revk/ESP32-Generic/PCB/Generic0/README.md

# Generic0

These files are for use in [KiCad](https://www.kicad.org).

## Trademark

This is an open source project, but bear in mind you cannot sell boards bearing the Andrews & Arnold Ltd name, the A&A logo, the registered trademark AJK logo, or the GS1 allocated EANs assigned to Andrews & Arnold Ltd.

## Images

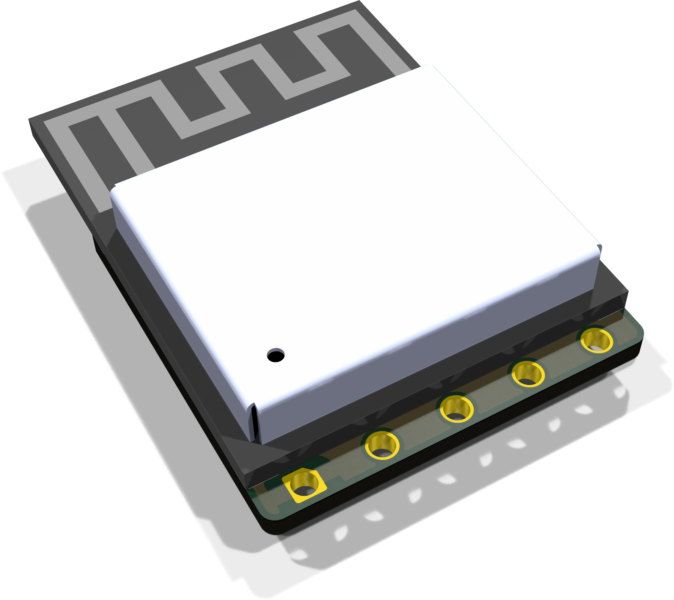
[picture p2: PCB/Generic0/Generic0.png]
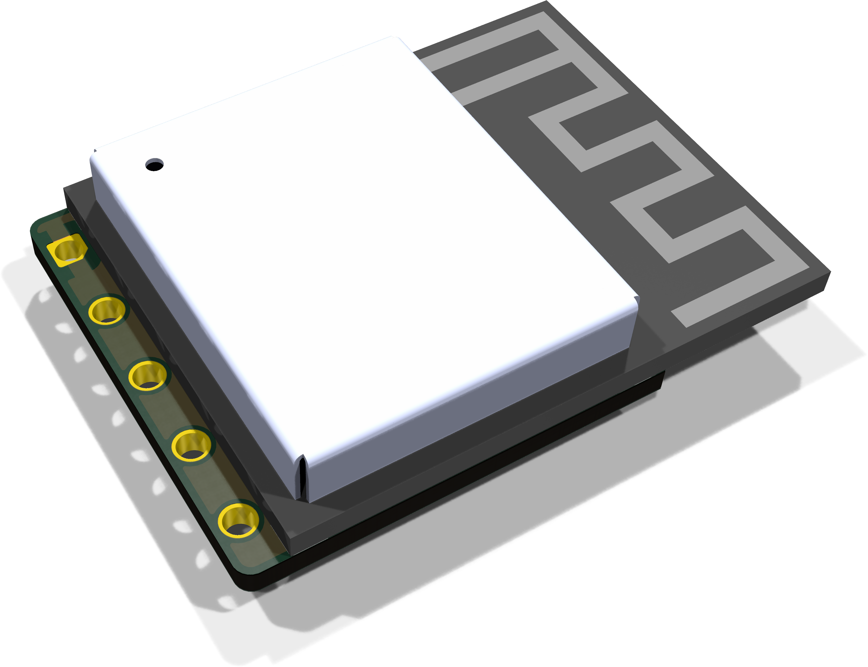
[picture p3: PCB/Generic0/Generic0-90.png]
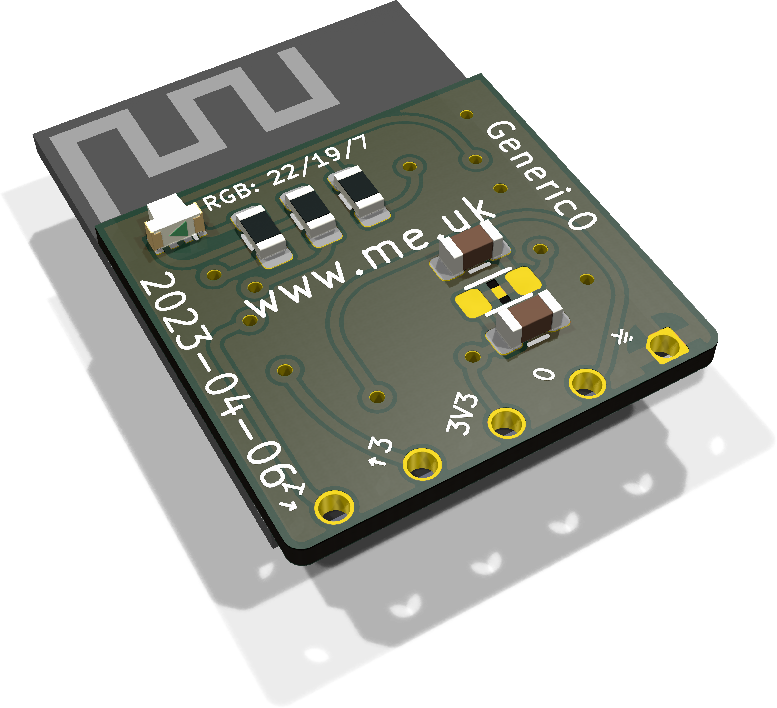
[picture p4: PCB/Generic0/Generic0-bottom.png]


*Auto generated 2025-08-24T13:27:21*
