revk/ESP32-Generic/PCB/Generic01/README.md

# Generic01

These files are for use in [KiCad](https://www.kicad.org).

## Trademark

This is an open source project, but bear in mind you cannot sell boards bearing the Andrews & Arnold Ltd name, the A&A logo, the registered trademark AJK logo, or the GS1 allocated EANs assigned to Andrews & Arnold Ltd.

## Images

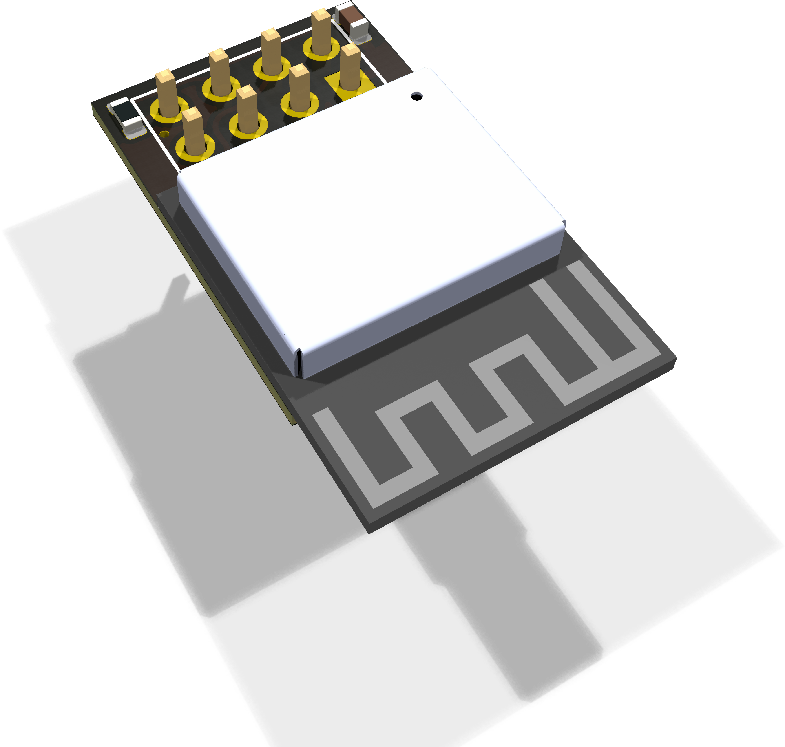
[picture p5: PCB/Generic01/Generic01.png]
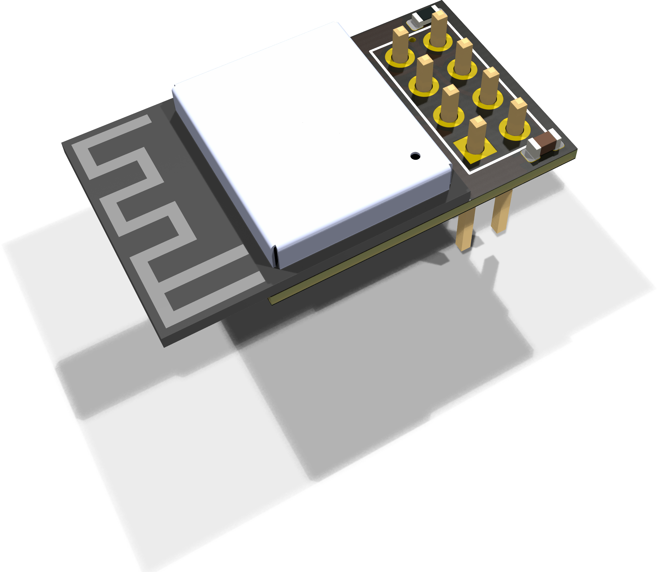
[picture p6: PCB/Generic01/Generic01-90.png]
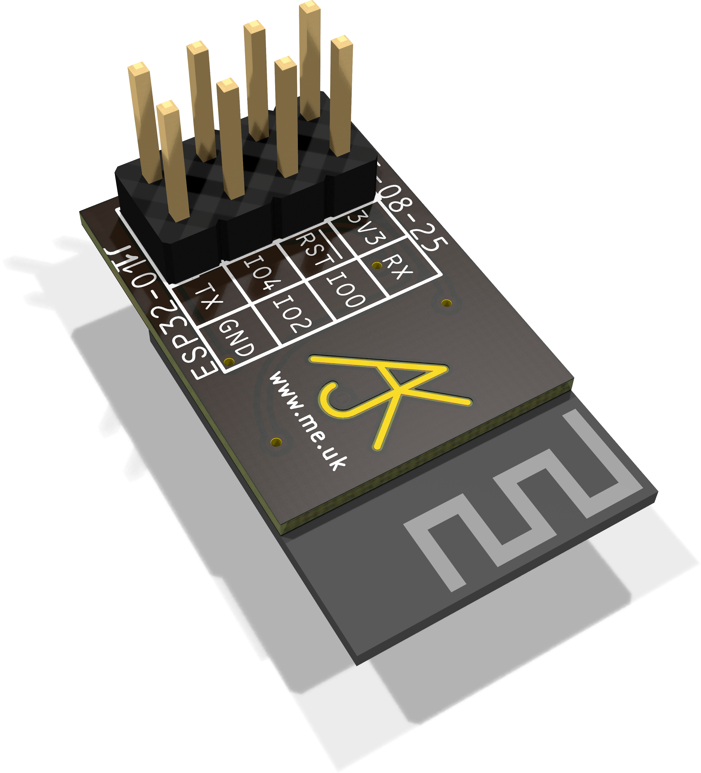
[picture p7: PCB/Generic01/Generic01-bottom.png]


*Auto generated 2025-08-24T13:28:44*
