revk/ESP32-Generic/PCB/Generic3/README.md

# Generic3

## Trademark

This is an open source project, but bear in mind you cannot sell boards bearing the Andrews & Arnold Ltd name, the A&A logo, the registered trademark AJK logo, or the GS1 allocated EANs assigned to Andrews & Arnold Ltd.

## PCB Designs

These files are for use with [KiCAD](https://www.kicad.org).

- [Generic3](Generic3.kicad_pro)
## 3D

3D case designs are normally automatically created from the PCB so as to ensure correct details and placement of apertures, etc.

- [Generic3](Generic3.stl)

## Images

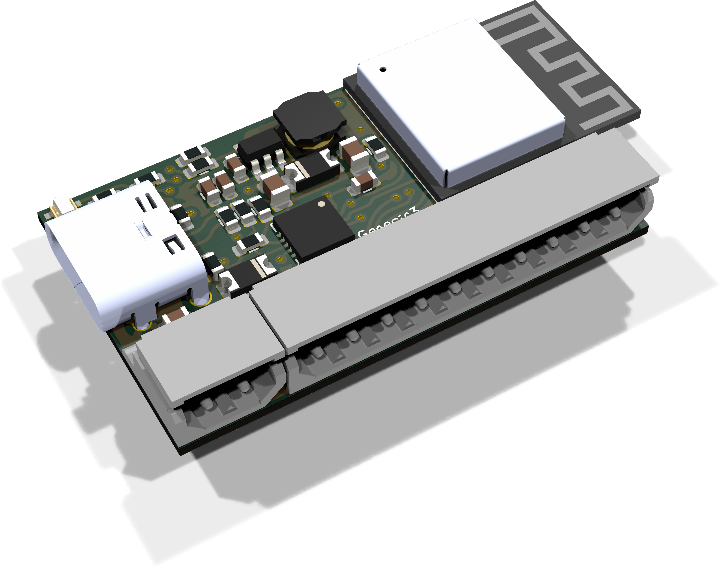
[picture p11: PCB/Generic3/Generic3.png]
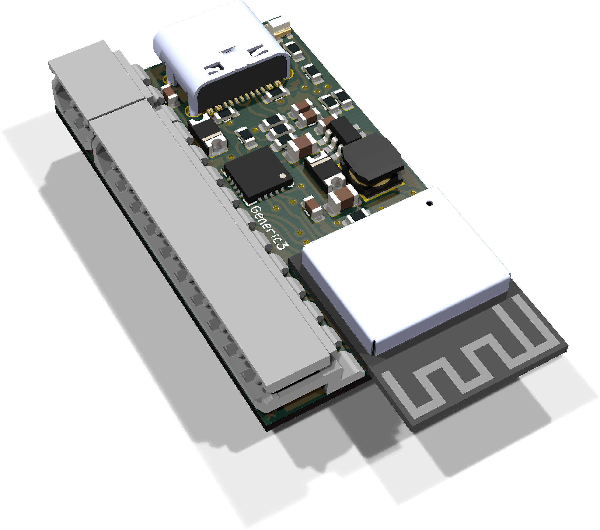
[picture p12: PCB/Generic3/Generic3-90.png]
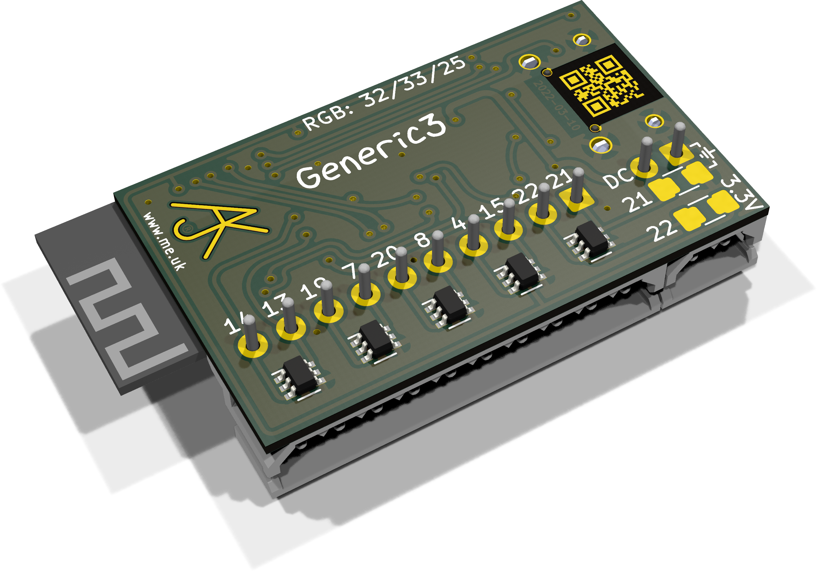
[picture p13: PCB/Generic3/Generic3-bottom.png]


---

*Auto generated README.md 2025-08-25T14:29:06*
