revk/ESP32-Generic/PCB/Generic4/README.md

# Generic4

## Trademark

This is an open source project, but bear in mind you cannot sell boards bearing the Andrews & Arnold Ltd name, the A&A logo, the registered trademark AJK logo, or the GS1 allocated EANs assigned to Andrews & Arnold Ltd.

## PCB Designs

These files are for use with [KiCAD](https://www.kicad.org).

- [Generic4](Generic4.kicad_pro)
## 3D

3D case designs are normally automatically created from the PCB so as to ensure correct details and placement of apertures, etc.

- [Generic4](Generic4.stl)

## Images

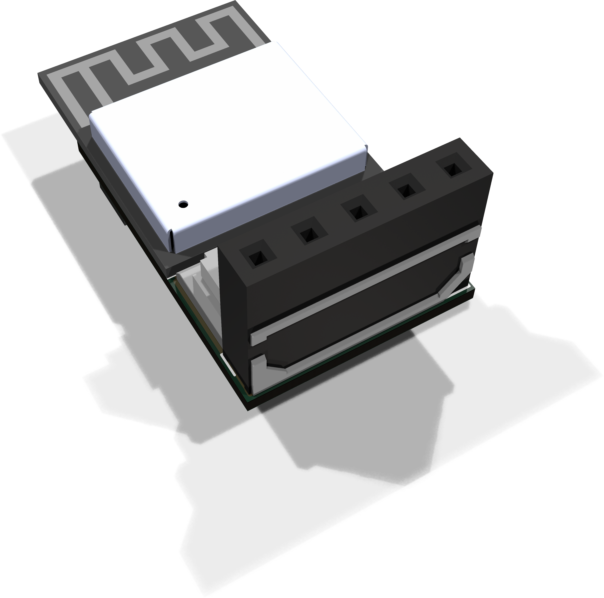
[picture p14: PCB/Generic4/Generic4.png]
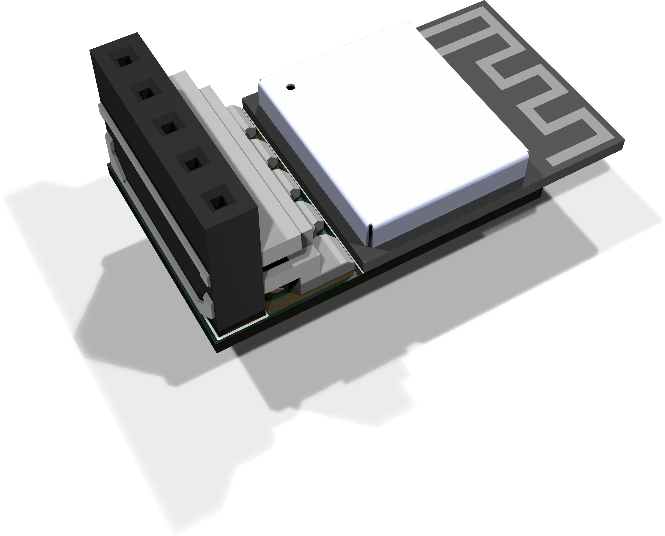
[picture p15: PCB/Generic4/Generic4-90.png]
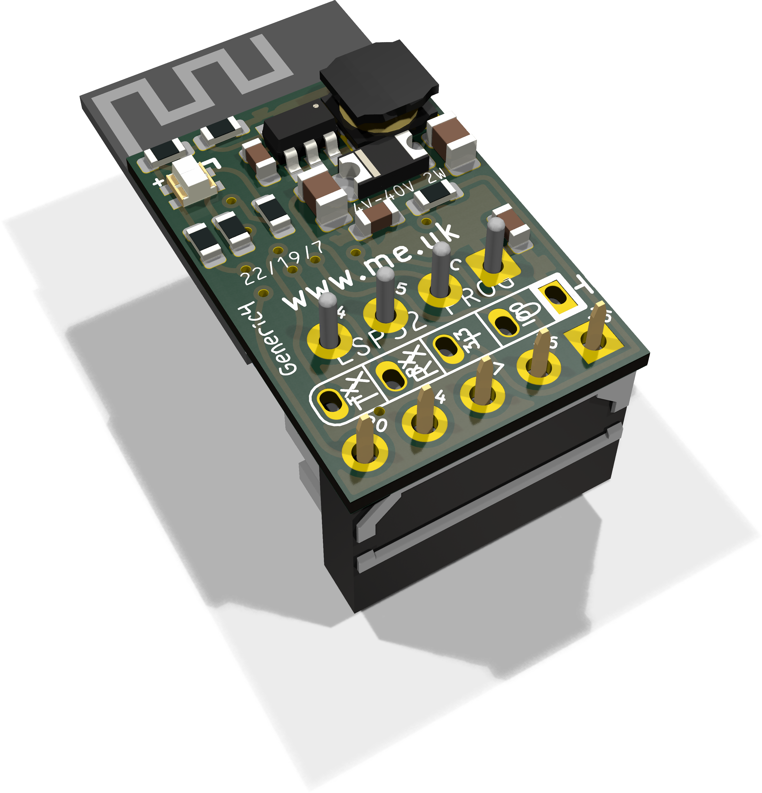
[picture p16: PCB/Generic4/Generic4-bottom.png]


---

*Auto generated README.md 2025-08-25T14:29:06*
