revk/ESP32-Generic/PCB/Generic6/README.md

# Generic6

These files are for use in [KiCad](https://www.kicad.org).

## Trademark

This is an open source project, but bear in mind you cannot sell boards bearing the Andrews & Arnold Ltd name, the A&A logo, the registered trademark AJK logo, or the GS1 allocated EANs assigned to Andrews & Arnold Ltd.

## Images

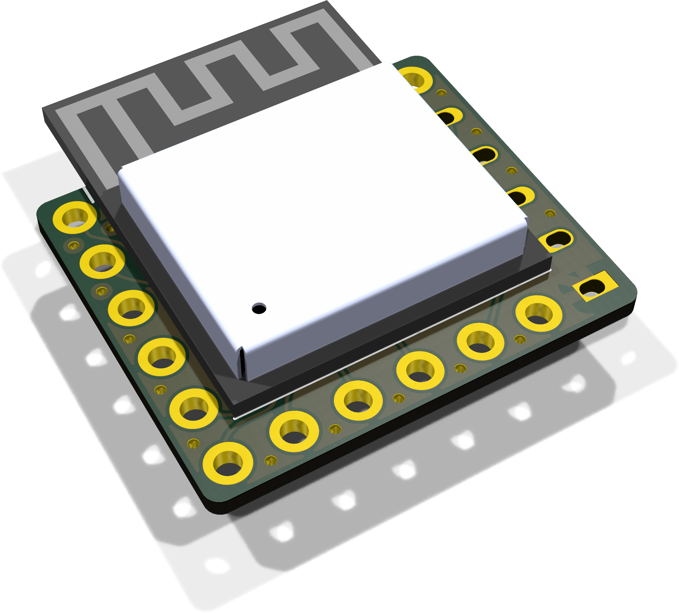
[picture p17: PCB/Generic6/Generic6.png]
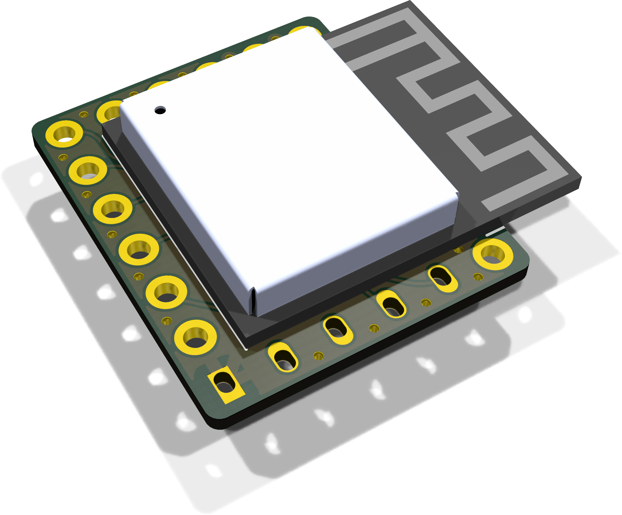
[picture p18: PCB/Generic6/Generic6-90.png]
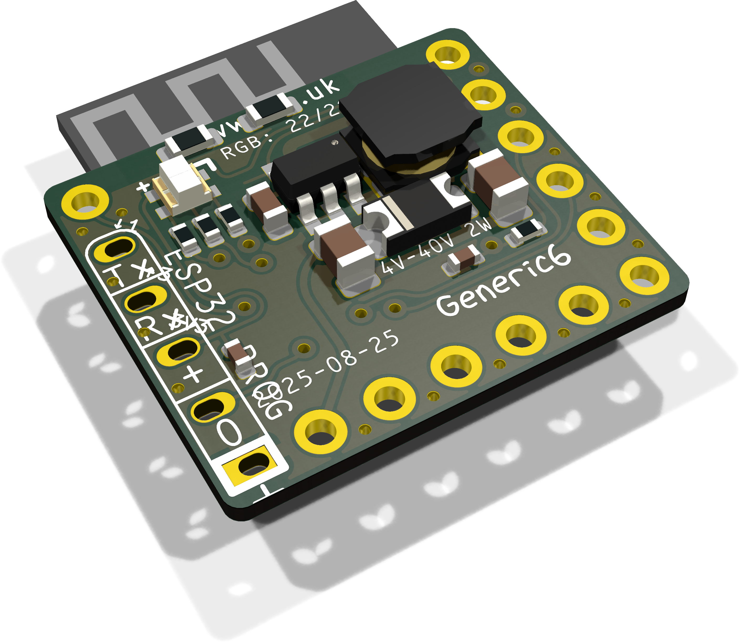
[picture p19: PCB/Generic6/Generic6-bottom.png]


*Auto generated 2025-08-24T13:35:26*
