revk/ESP32-Generic/PCB/GenericS3/README.md

# GenericS3

## Trademark

This is an open source project, but bear in mind you cannot sell boards bearing the Andrews & Arnold Ltd name, the A&A logo, the registered trademark AJK logo, or the GS1 allocated EANs assigned to Andrews & Arnold Ltd.

## PCB Designs

These files are for use with [KiCAD](https://www.kicad.org).

- [GenericS3](GenericS3.kicad_pro)
## 3D

3D case designs are normally automatically created from the PCB so as to ensure correct details and placement of apertures, etc.

|Design|Bottom|Top|
|---|---|---|
|GenericS3|[GenericS3B](GenericS3B.stl)|[GenericS3T](GenericS3T.stl)|

## Images

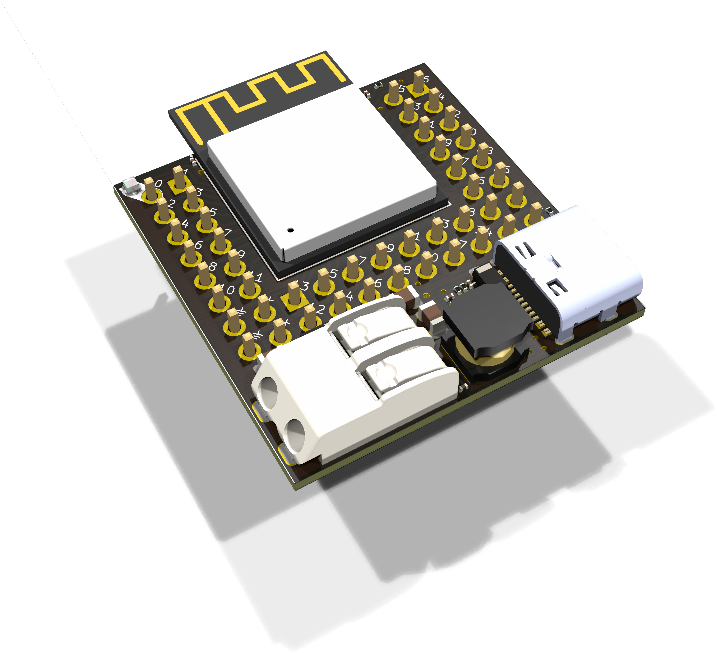
[picture p20: PCB/GenericS3/GenericS3-90.png]
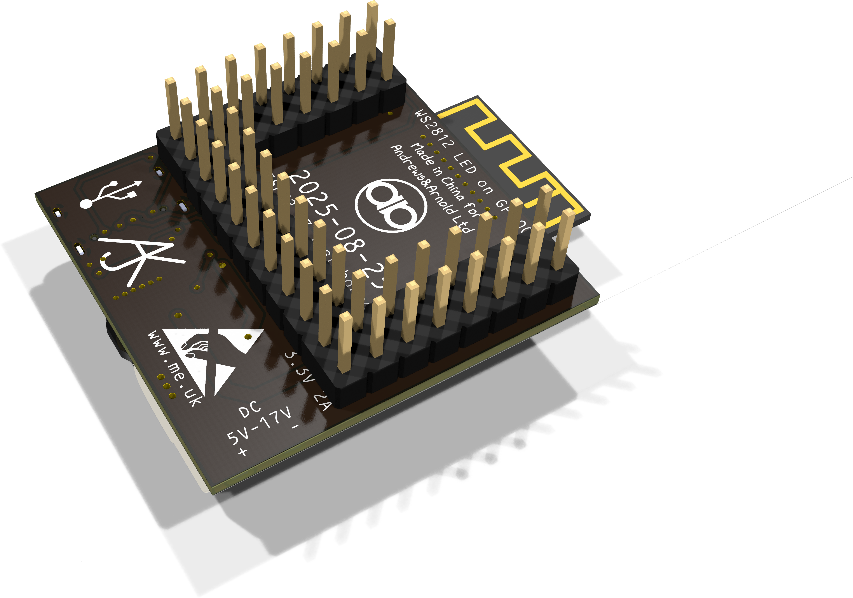
[picture p21: PCB/GenericS3/GenericS3-bottom.png]

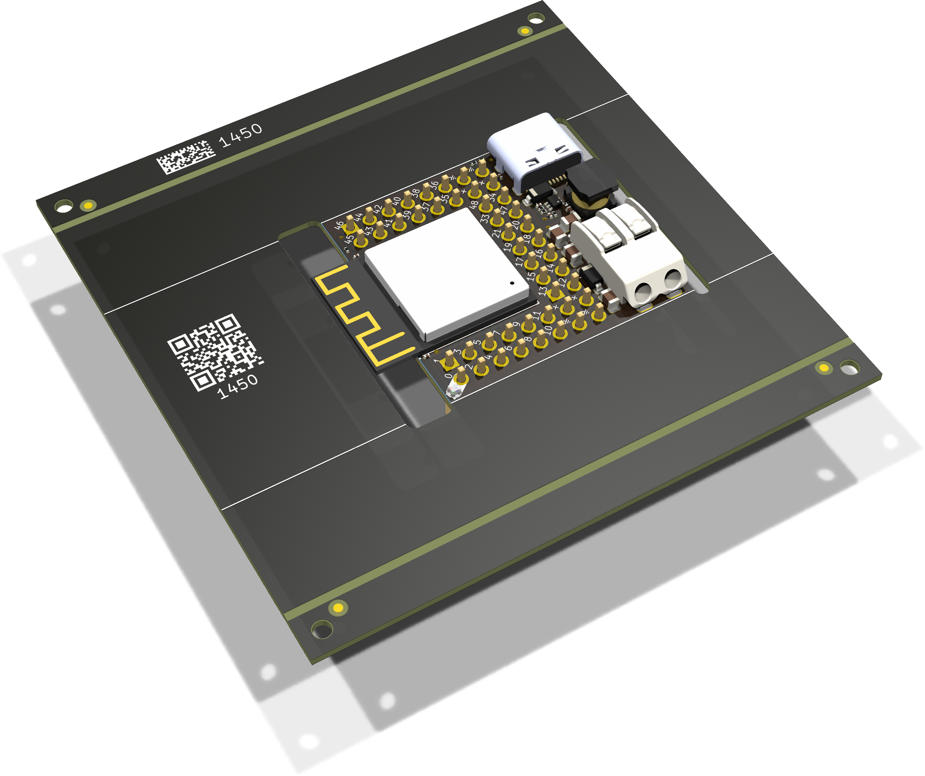
[picture p22: PCB/GenericS3/GenericS3-panel.png]
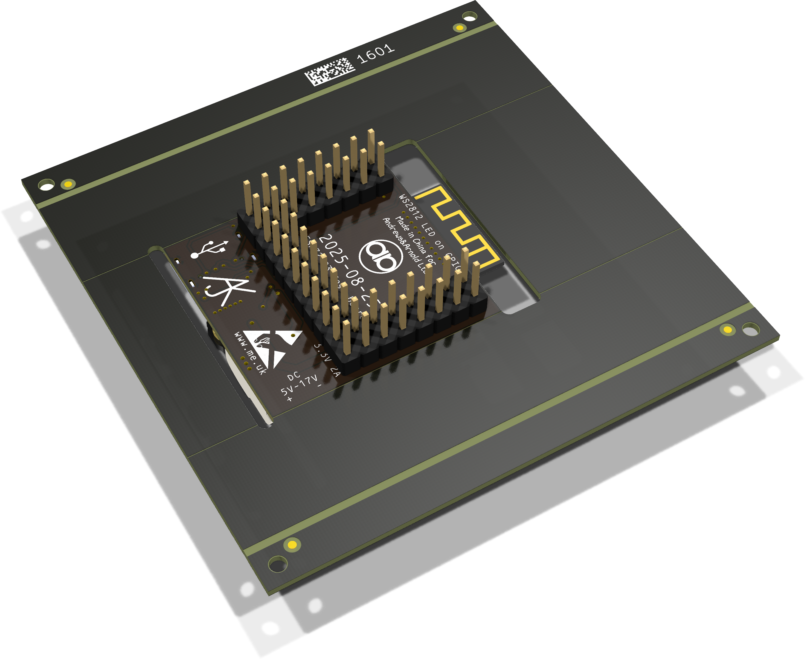
[picture p23: PCB/GenericS3/GenericS3-panel-bottom.png]


---

*Auto generated README.md 2025-08-25T15:22:12*
