revk/ESP32-Generic/PCB/GenericS3Bat/README.md

# GenericS3

These files are for use in [KiCad](https://www.kicad.org).

## Trademark

This is an open source project, but bear in mind you cannot sell boards bearing the Andrews & Arnold Ltd name, the A&A logo, the registered trademark AJK logo, or the GS1 allocated EANs assigned to Andrews & Arnold Ltd.

## Images

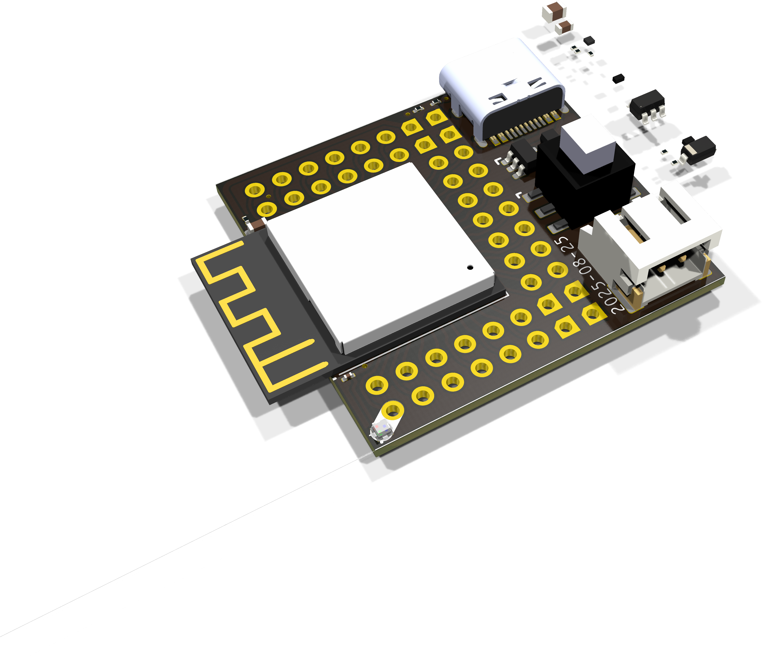
[picture p24: PCB/GenericS3Bat/GenericS3.png]
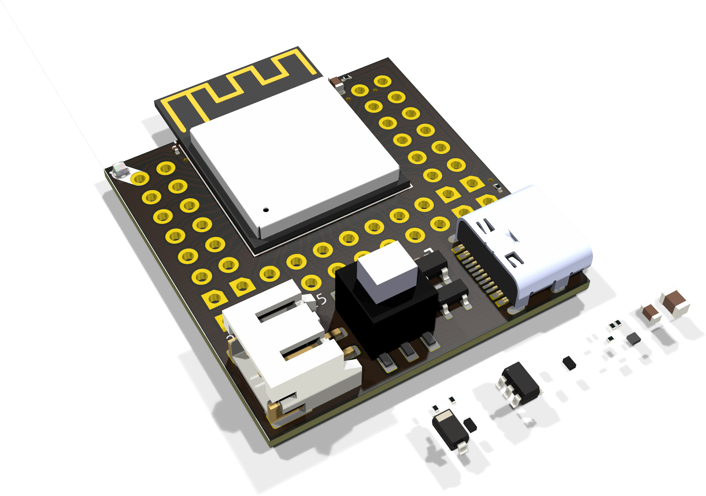
[picture p25: PCB/GenericS3Bat/GenericS3-90.png]
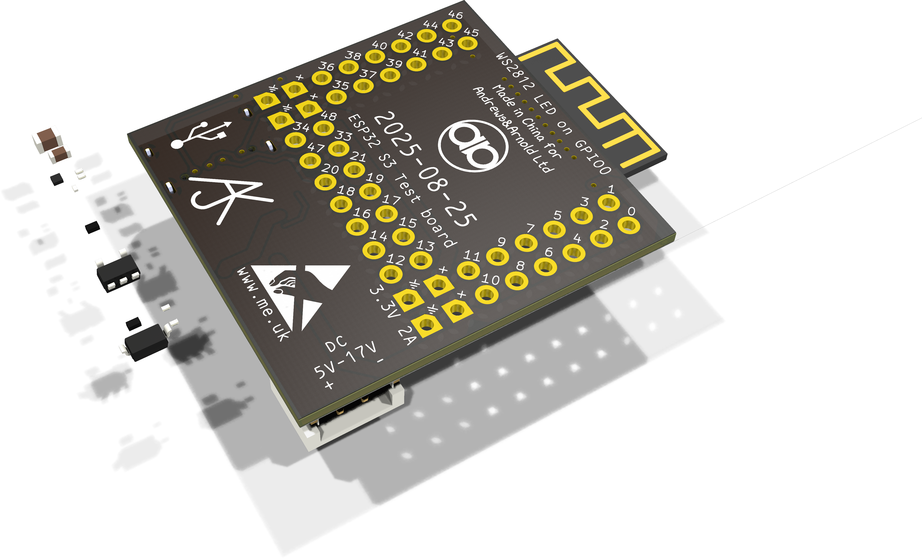
[picture p26: PCB/GenericS3Bat/GenericS3-bottom.png]

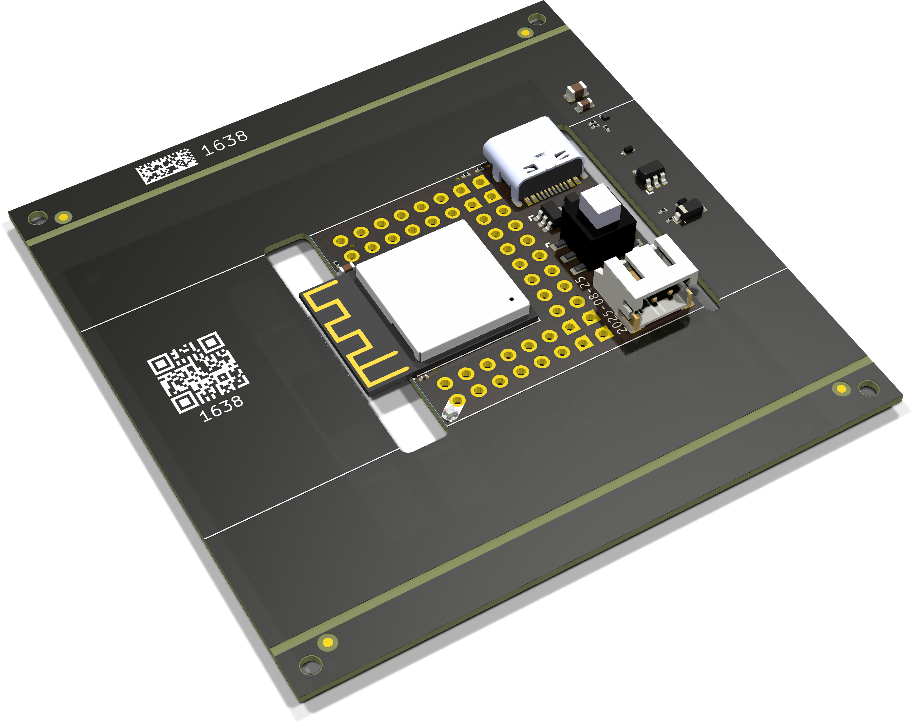
[picture p27: PCB/GenericS3Bat/GenericS3-panel.png]
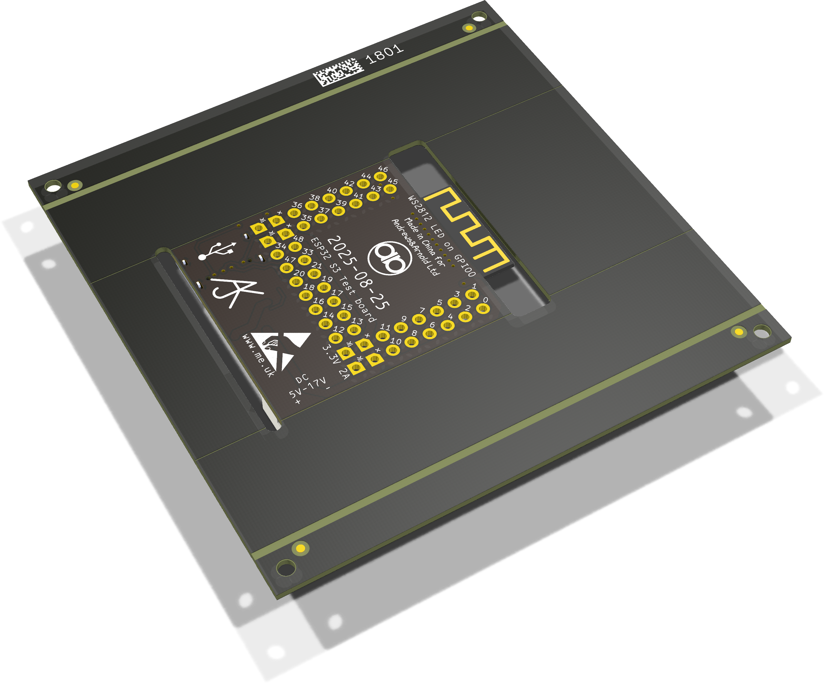
[picture p28: PCB/GenericS3Bat/GenericS3-panel-bottom.png]


*Auto generated 2025-08-24T13:42:13*
