revk/ESP32-Generic/PCB/LowPower/README.md

# LowPower

## Trademark

This is an open source project, but bear in mind you cannot sell boards bearing the Andrews & Arnold Ltd name, the A&A logo, the registered trademark AJK logo, or the GS1 allocated EANs assigned to Andrews & Arnold Ltd.

## PCB Designs

These files are for use with [KiCAD](https://www.kicad.org).

- [LowPower](LowPower.kicad_pro)
## 3D

3D case designs are normally automatically created from the PCB so as to ensure correct details and placement of apertures, etc.

- [LowPower](LowPower.stl)

## Images

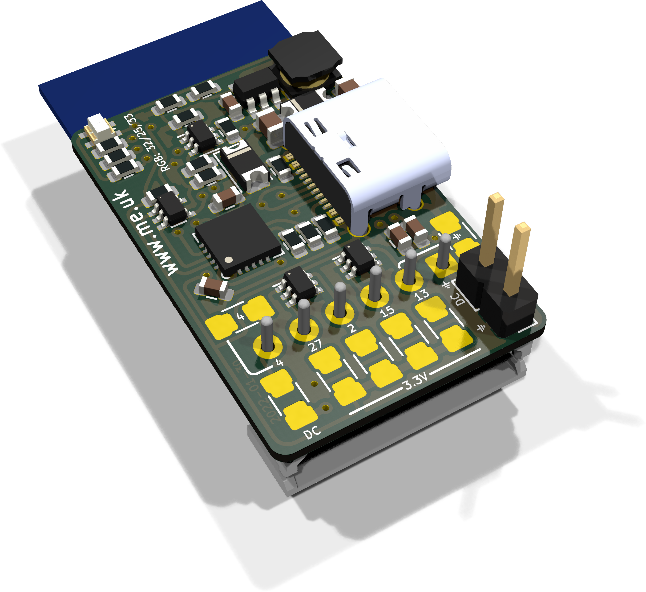
[picture p29: PCB/LowPower/LowPower.png]
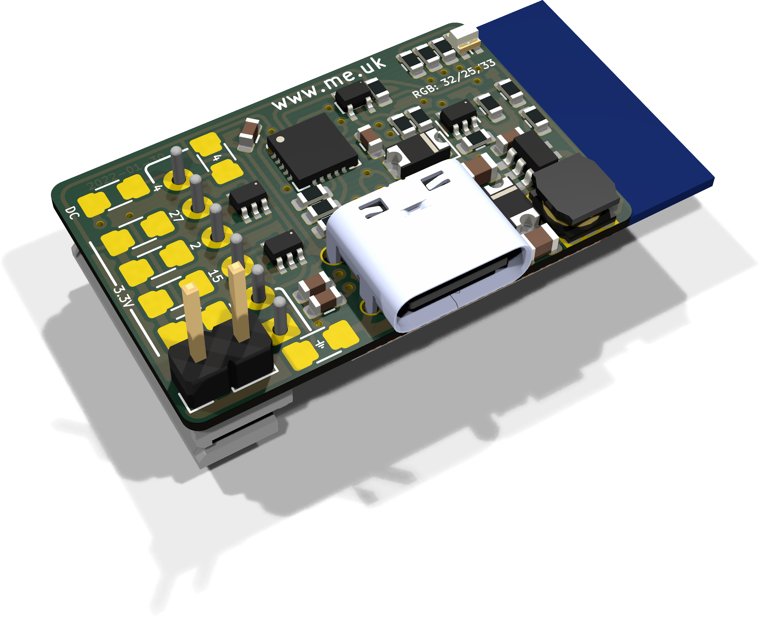
[picture p30: PCB/LowPower/LowPower-90.png]
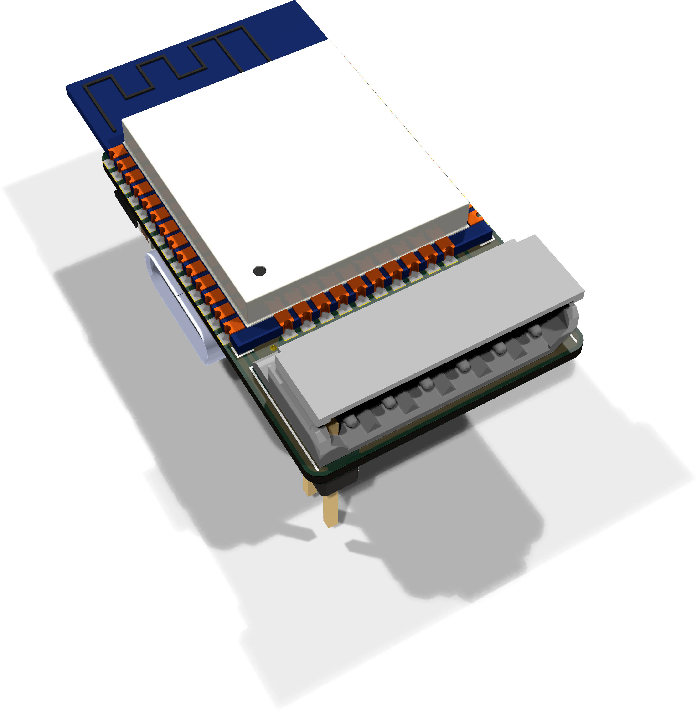
[picture p31: PCB/LowPower/LowPower-bottom.png]


---

*Auto generated README.md 2025-08-25T14:29:06*
