revk/ESP32-Generic/PCB/USBC/README.md

# USBC

These files are for use in [KiCad](https://www.kicad.org).

## Trademark

This is an open source project, but bear in mind you cannot sell boards bearing the Andrews & Arnold Ltd name, the A&A logo, the registered trademark AJK logo, or the GS1 allocated EANs assigned to Andrews & Arnold Ltd.

## Images

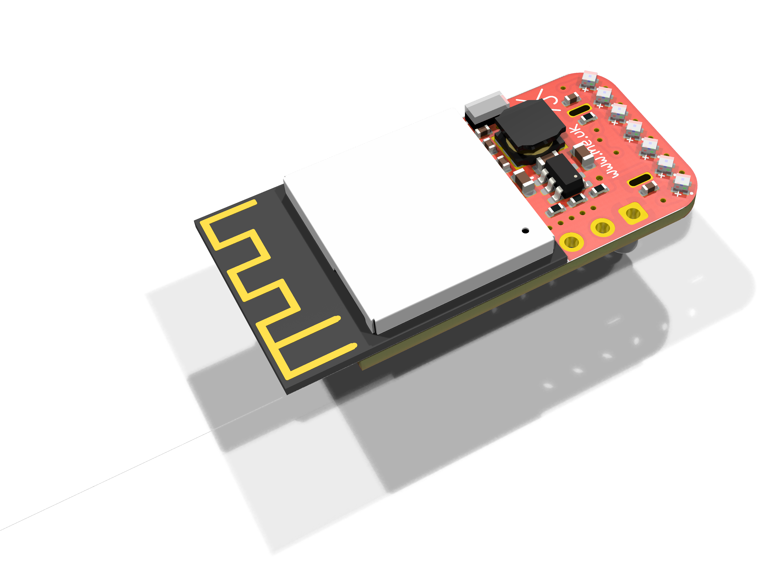
[picture p32: PCB/USBC/USBC.png]
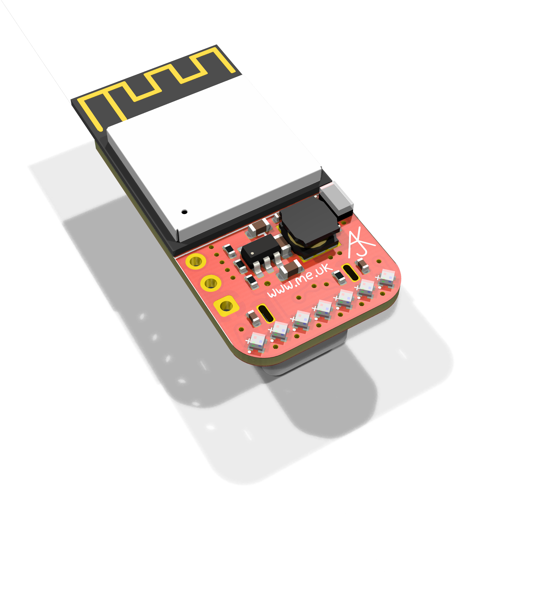
[picture p33: PCB/USBC/USBC-90.png]
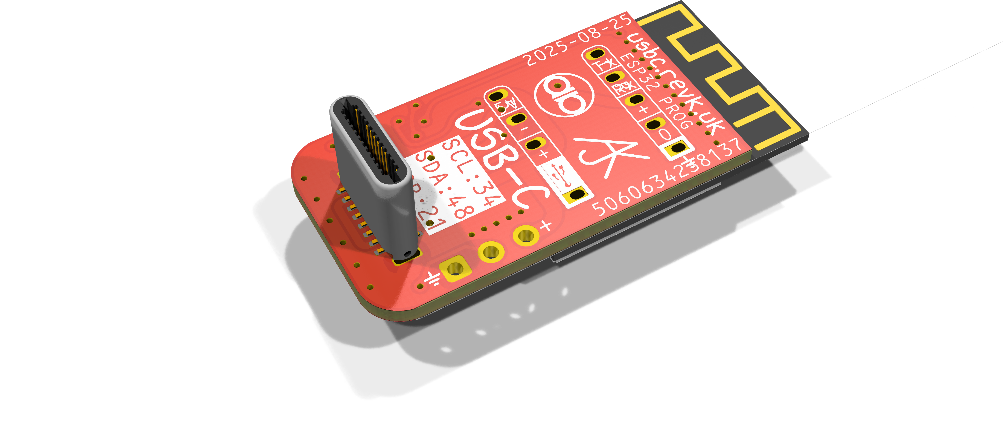
[picture p34: PCB/USBC/USBC-bottom.png]

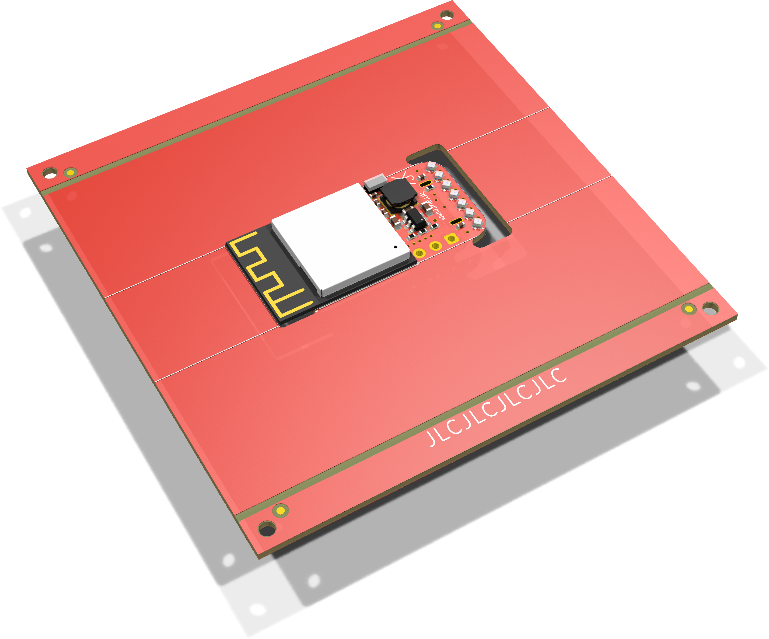
[picture p35: PCB/USBC/USBC-panel.png]
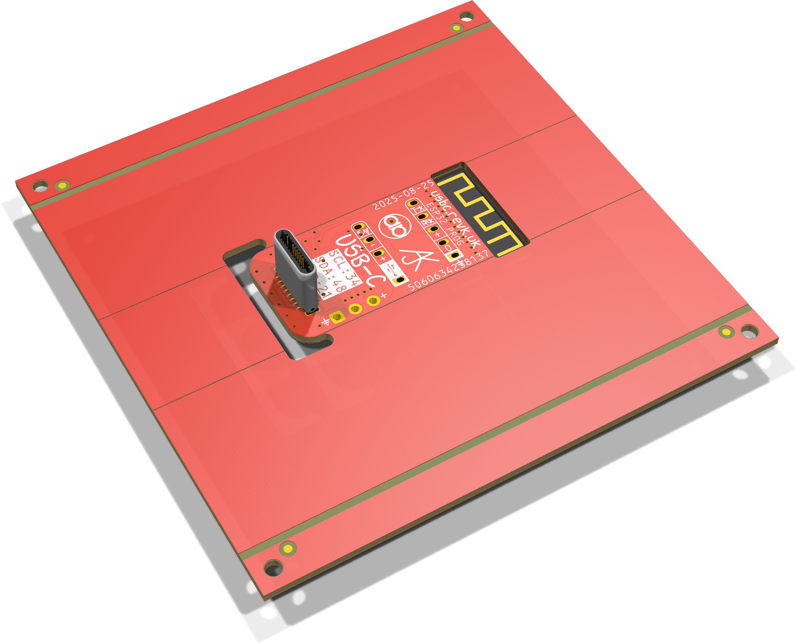
[picture p36: PCB/USBC/USBC-panel-bottom.png]


*Auto generated 2025-08-24T13:46:48*
