revk/ESP32-Generic/PCB/Generic0/Back.png

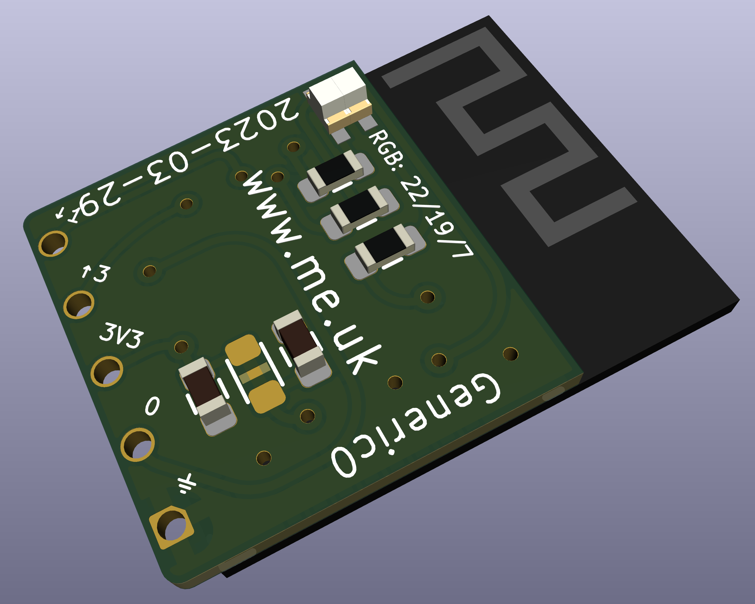
PCB/Generic0/Back.png
