revk/ESP32-Generic/PCB/Generic0/Front.png

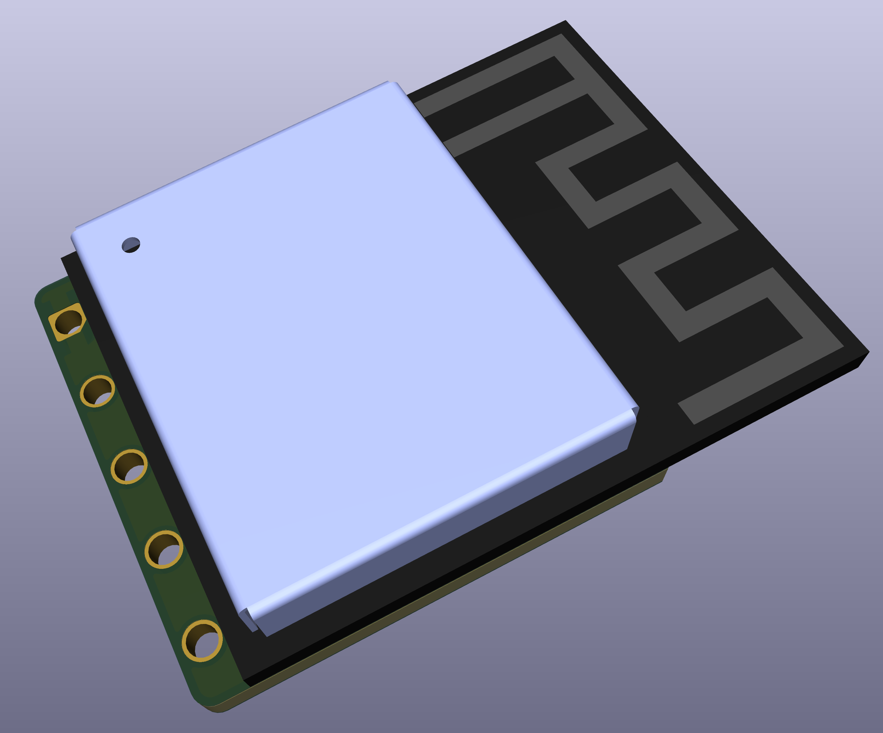
PCB/Generic0/Front.png
