revk/ESP32-Generic/PCB/Generic/Generic-90.png

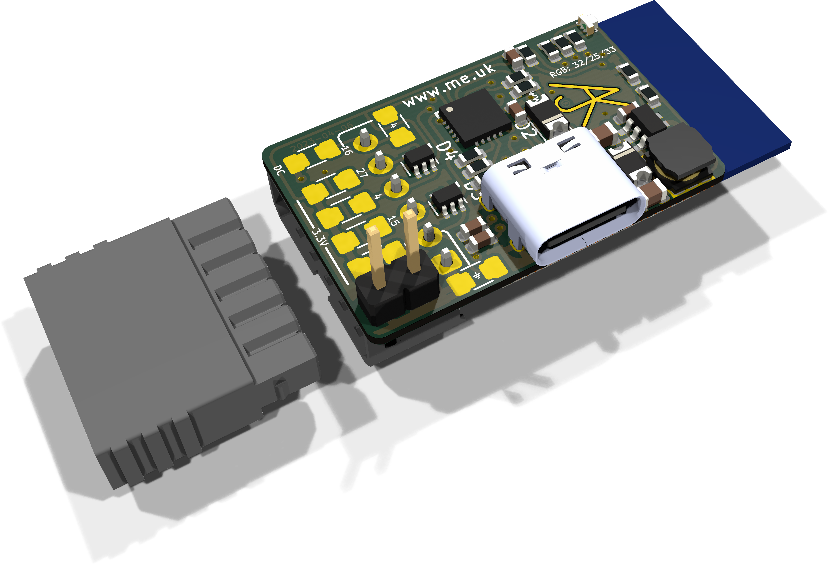
PCB/Generic/Generic-90.png
