revk/ESP32-Generic/PCB/Generic/Generic-bottom.png

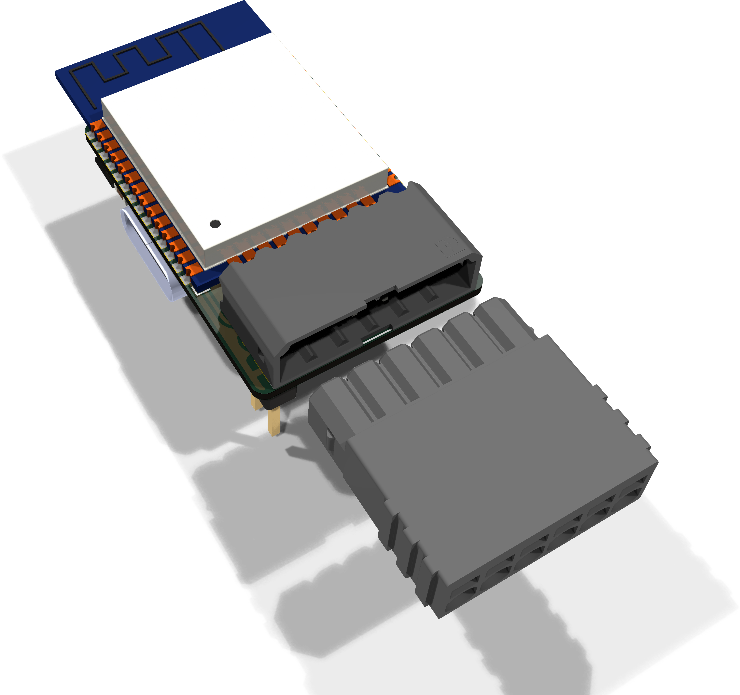
PCB/Generic/Generic-bottom.png
