revk/ESP32-Generic/PCB/Generic/Generic.png

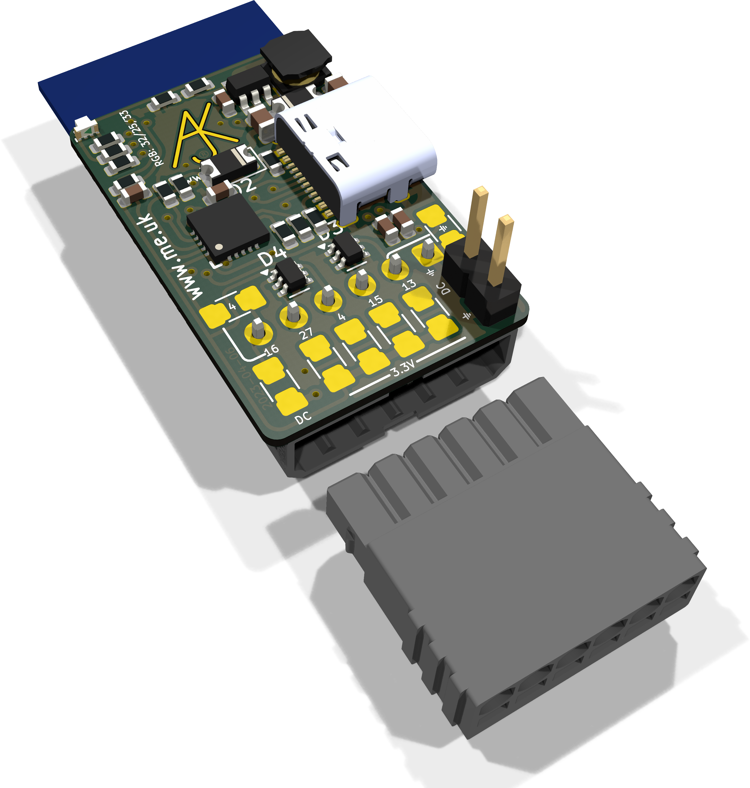
PCB/Generic/Generic.png
