revk/ESP32-Generic/PCB/GenericS3/Back.png

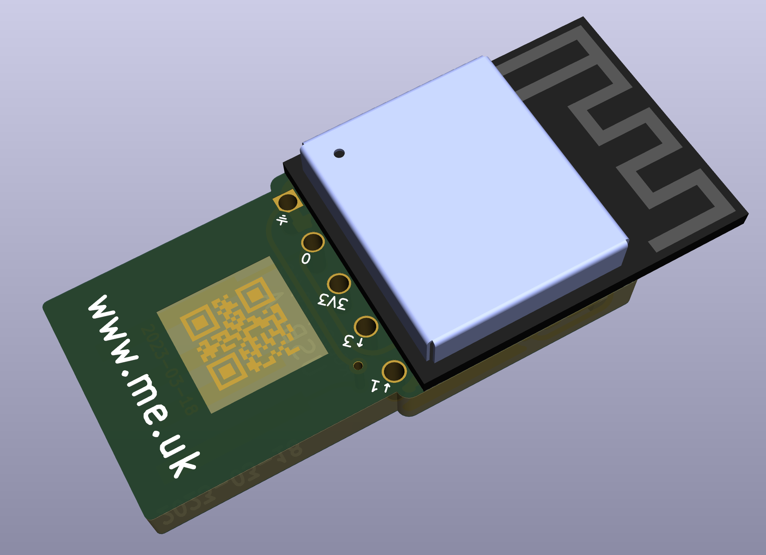
PCB/GenericS3/Back.png
