revk/ESP32-Generic/PCB/GenericS3/Example.png

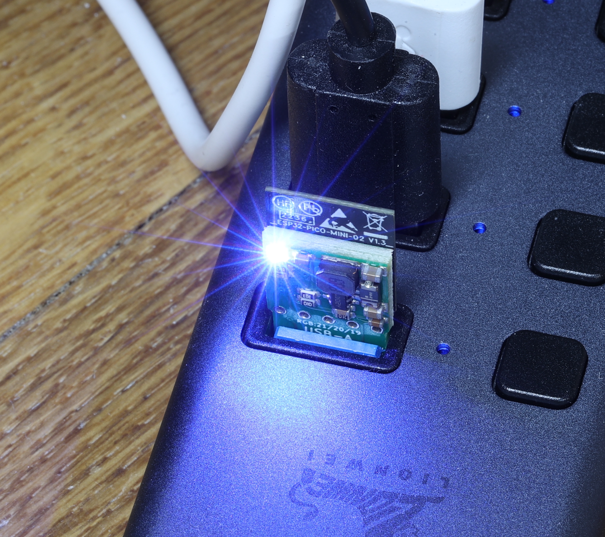
PCB/GenericS3/Example.png
