revk/ESP32-Generic/PCB/GenericS3/Front.png

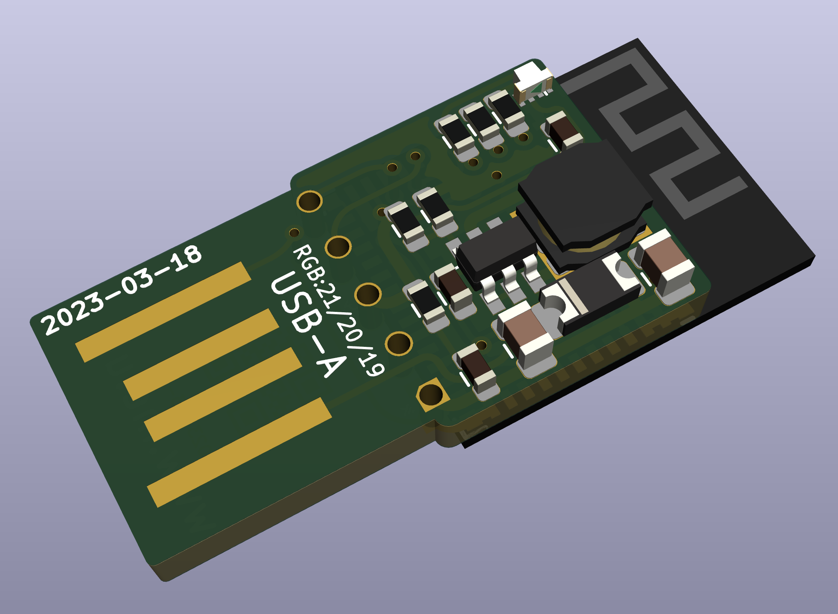
PCB/GenericS3/Front.png
