revk/ESP32-Generic/PCB/Generic0/production/bom.csv

Designator | Footprint | Quantity | Value | LCSC Part #
C1 | C_0603 | 1 | 10nF
C2 | C_0603 | 1 | 100nF
D1 | MHS190RGBCT | 1 | LED_BARG | C409798
J1 | Shelly | 1 | Shelly
R1 | R_0603 | 1 | 300R
R2 | R_0603 | 1 | 1K
R3 | R_0603 | 1 | 100R
R4 | Pad_0603_Bridged | 1 | 10K
U1 | ESP32-PICO-MINI-02 | 1 | ESP32-PICO-MINI-02
