revk/ESP32-Generic/PCB/Generic/Generic.stl

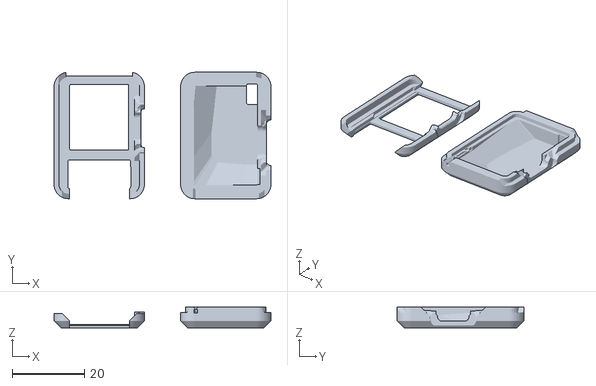
[picture p45: CAD file, 2023-04-07]
PCB/Generic/Generic.stl
60.0 x 35.0 x 5.80
