revk/ESP32-Generic/PCB/Generic2/Generic2.stl

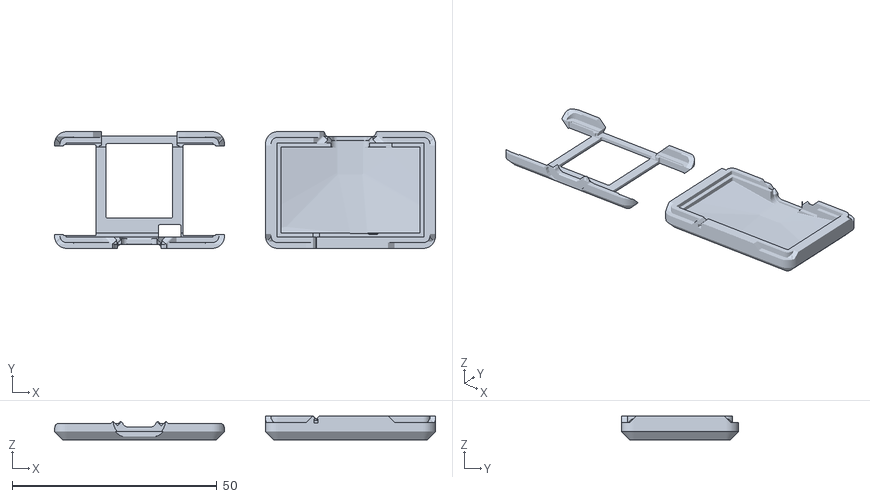
[picture p46: CAD file, 2023-04-07]
PCB/Generic2/Generic2.stl
93.0 x 28.5 x 5.80
