revk/ESP32-Generic/PCB/Generic3/Generic3.stl

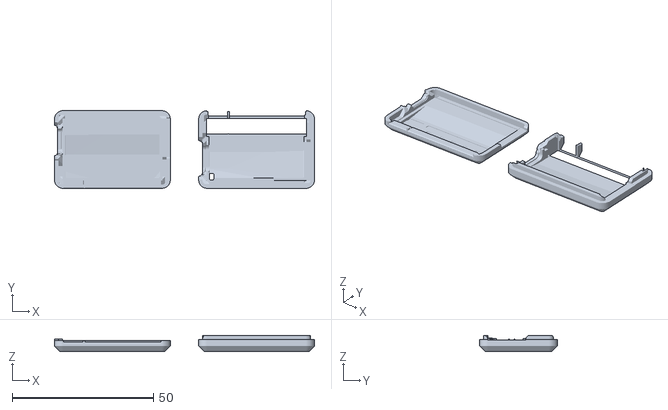
[picture p47: CAD file, 2023-04-07]
PCB/Generic3/Generic3.stl
92.0 x 27.5 x 5.80
