revk/ESP32-Generic/PCB/Generic4/Generic4.stl

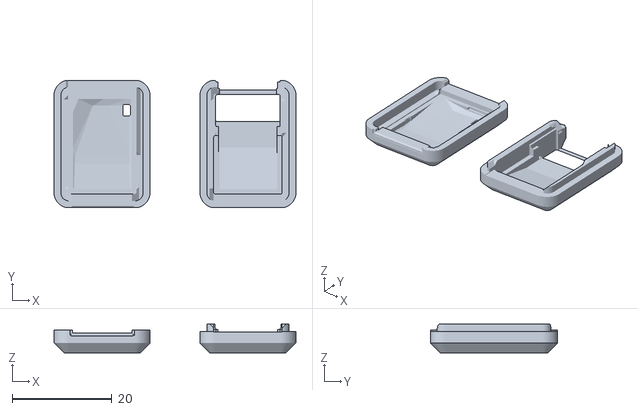
[picture p48: CAD file, 2023-04-07]
PCB/Generic4/Generic4.stl
48.4 x 25.5 x 5.80
