revk/ESP32-Generic/PCB/GenericS3/GenericS3T.stl

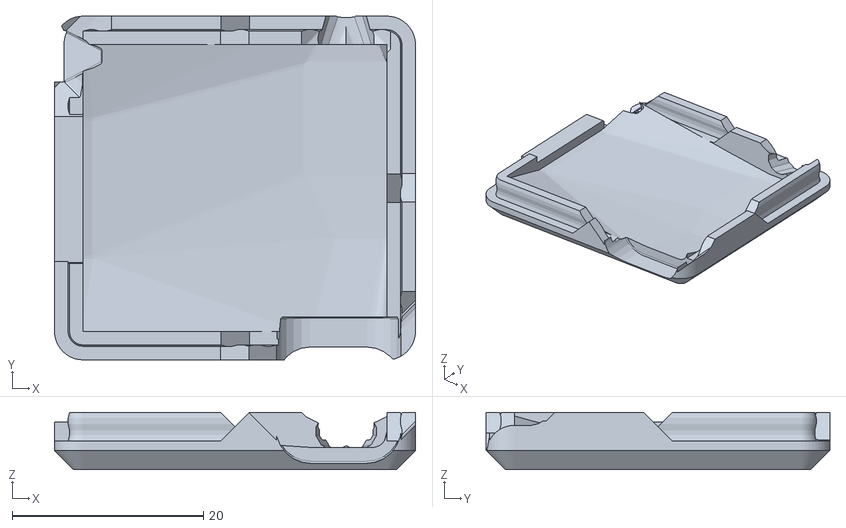
[picture p49: CAD file, 2025-11-13]
PCB/GenericS3/GenericS3T.stl
37.8 x 36.0 x 5.99
