revk/ESP32-Generic/PCB/LowPower/LowPower.stl

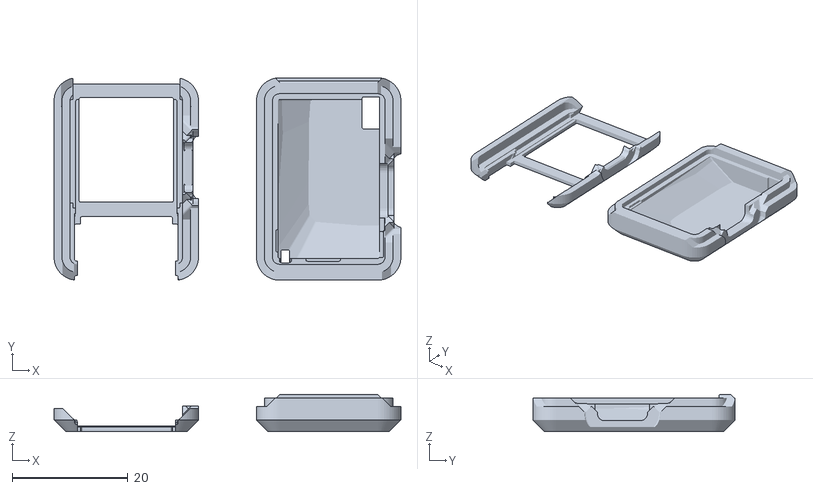
[picture p50: CAD file, 2023-04-07]
PCB/LowPower/LowPower.stl
60.0 x 35.0 x 6.40
