revk/ESP32-Generic/PCB/GenericS3/GenericS3B.stl

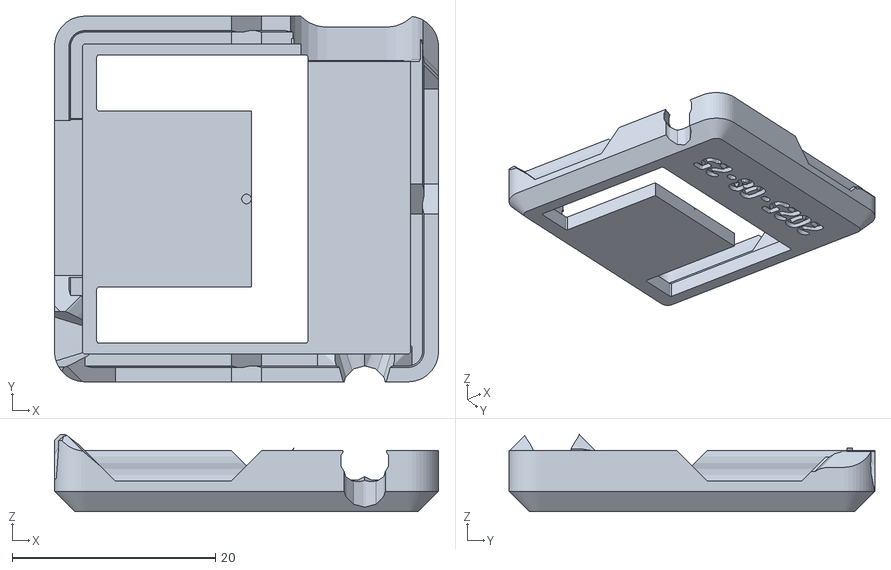
[picture p51: CAD file, 2025-11-13]
PCB/GenericS3/GenericS3B.stl
37.8 x 36.0 x 7.59
