revk/ESP32-Generic/(list of files, cad)

Other CAD files:
PCB/Generic2/Generic2.scad
PCB/Generic3/Generic3.scad
PCB/Generic4/Generic4.scad
PCB/GenericS3/GenericS3T.scad
PCB/LowPower/LowPower.scad
