revk/ESP32-Generic/(commit log)

2021-05-20 Battery PCB
    [Battery-B_Cu.gbr, Battery-B_Mask.gbr, Battery-B_Paste.gbr, Battery-B_SilkS.gbr, Battery-Edge_Cuts.gbr, Battery-F_Cu.gbr, Battery-F_Mask.gbr, Battery-F_Paste.gbr]
2021-05-20 Fucked up footprint.
    [Battery-B_Cu.gbr, Battery-B_Mask.gbr, Battery-B_Paste.gbr, Battery-B_SilkS.gbr, Battery-Edge_Cuts.gbr, Battery-F_Cu.gbr, Battery-F_Mask.gbr, Battery-F_Paste.gbr]
2021-05-22 Tidy up PCB
    [Battery-B_Cu.gbr, Battery-B_Mask.gbr, Battery-B_Paste.gbr, Battery-B_SilkS.gbr, Battery-Edge_Cuts.gbr, Battery-F_Cu.gbr, Battery-F_Mask.gbr, Battery-F_Paste.gbr]
2021-05-22 Still too much current
2021-05-22 Library update
    [Battery-B_Cu.gbr, Battery-B_Mask.gbr, Battery-B_Paste.gbr, Battery-B_SilkS.gbr, Battery-Edge_Cuts.gbr, Battery-F_Cu.gbr, Battery-F_Mask.gbr, Battery-F_Paste.gbr]
2021-05-22 Tidy, low current now
    [Battery-B_Cu.gbr, Battery-B_Mask.gbr, Battery-B_Paste.gbr, Battery-B_SilkS.gbr, Battery-Edge_Cuts.gbr, Battery-F_Cu.gbr, Battery-F_Mask.gbr, Battery-F_Paste.gbr]
2021-05-22 Still broken!
    [Battery.sch]
2021-05-22 Fixed circuit
    [Battery-B_Cu.gbr, Battery-B_Mask.gbr, Battery-B_Paste.gbr, Battery-B_SilkS.gbr, Battery-Edge_Cuts.gbr, Battery-F_Cu.gbr, Battery-F_Mask.gbr, Battery-F_Paste.gbr]
2021-05-22 Pin out
    [Battery.sch]
2021-05-23 New regulator
    [Battery-B_Cu.gbr, Battery-B_Mask.gbr, Battery-B_Paste.gbr, Battery-B_SilkS.gbr, Battery-Edge_Cuts.gbr, Battery-F_Cu.gbr, Battery-F_Mask.gbr, Battery-F_Paste.gbr]
2021-05-23 Tweak regulater
    [Battery-B_Cu.gbr, Battery-B_Mask.gbr, Battery-B_Paste.gbr, Battery-B_SilkS.gbr, Battery-Edge_Cuts.gbr, Battery-F_Cu.gbr, Battery-F_Mask.gbr, Battery-F_Paste.gbr]
2021-05-24 Added BCD_Charger
    [Battery-B_Cu.gbr, Battery-B_Mask.gbr, Battery-B_Paste.gbr, Battery-B_SilkS.gbr, Battery-Edge_Cuts.gbr, Battery-F_Cu.gbr, Battery-F_Mask.gbr, Battery-F_Paste.gbr]
2021-05-24 USB present is powered CBUS pin
    [Battery.kicad_pcb, Battery.sch]
2021-05-24 Lower power
2021-05-27 Update documentation
    [Battery-B_Cu.gbr, Battery-B_Mask.gbr, Battery-B_Paste.gbr, Battery-B_SilkS.gbr, Battery-Edge_Cuts.gbr, Battery-F_Cu.gbr, Battery-F_Mask.gbr, Battery-F_Paste.gbr]
2021-05-27 Wrong footprint FFS
    [Battery-B_Cu.gbr, Battery-B_Mask.gbr, Battery-B_Paste.gbr, Battery-B_SilkS.gbr, Battery-Edge_Cuts.gbr, Battery-F_Cu.gbr, Battery-F_Mask.gbr, Battery-F_Paste.gbr]
2021-05-27 Fix close via
    [Battery-B_Cu.gbr, Battery-B_Mask.gbr, Battery-B_Paste.gbr, Battery-B_SilkS.gbr, Battery-Edge_Cuts.gbr, Battery-F_Cu.gbr, Battery-F_Mask.gbr, Battery-F_Paste.gbr]
2021-05-28 LED is -ve
2021-05-30 Power up start
2021-05-31 Tidy drawing
    [Battery.kicad_pcb, Battery.stl]
2021-06-17 Better footprint for solder paste
    [Battery-B_Cu.gbr, Battery-B_Mask.gbr, Battery-B_Paste.gbr, Battery-B_SilkS.gbr, Battery-Edge_Cuts.gbr, Battery-F_Cu.gbr, Battery-F_Mask.gbr, Battery-F_Paste.gbr]
2021-06-20 Reworked with RGB LED, and 27R for USB and protection diodes...
    [Battery-B_Cu.gbr, Battery-B_Mask.gbr, Battery-B_Paste.gbr, Battery-B_SilkS.gbr, Battery-Edge_Cuts.gbr, Battery-F_Cu.gbr, Battery-F_Mask.gbr, Battery-F_Paste.gbr]
2021-06-20 Extra caps on USB as per data sheet
    [Battery-B_Cu.gbr, Battery-B_Mask.gbr, Battery-B_Paste.gbr, Battery-B_SilkS.gbr, Battery-Edge_Cuts.gbr, Battery-F_Cu.gbr, Battery-F_Mask.gbr, Battery-F_Paste.gbr]
2021-06-20 Documentation update
    [Battery.kicad_pcb]
2021-06-20 Clean up ground fill a bit
    [Battery-B_Cu.gbr, Battery-B_Mask.gbr, Battery-B_Paste.gbr, Battery-B_SilkS.gbr, Battery-Edge_Cuts.gbr, Battery-F_Cu.gbr, Battery-F_Mask.gbr, Battery-F_Paste.gbr]
2021-07-06 New footprint
    [Battery.kicad_pcb]
2021-07-09 Less solder on USB
    [Battery-B_Cu.gbr, Battery-B_Mask.gbr, Battery-B_Paste.gbr, Battery-B_SilkS.gbr, Battery-Edge_Cuts.gbr, Battery-F_Cu.gbr, Battery-F_Mask.gbr, Battery-F_Paste.gbr]
2021-07-10 Fix LED
    [Battery-B_Cu.gbr, Battery-B_Mask.gbr, Battery-B_Paste.gbr, Battery-B_SilkS.gbr, Battery-Edge_Cuts.gbr, Battery-F_Cu.gbr, Battery-F_Mask.gbr, Battery-F_Paste.gbr]
2021-07-20 Changed name
    [Battery-nohole.stl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]
2021-07-28 Filling out data in schematic
    [Generic.kicad_pcb, Generic.sch]
2021-08-24 Clean up
    [Generic-B_Cu.gbr, Generic-B_Mask.gbr, Generic-B_Paste.gbr, Generic-B_SilkS.gbr, Generic-Edge_Cuts.gbr, Generic-F_Cu.gbr, Generic-F_Mask.gbr, Generic-F_Paste.gbr]
2021-08-26 New regulator block
    [Generic-B_Cu.gbr, Generic-B_Mask.gbr, Generic-B_Paste.gbr, Generic-B_SilkS.gbr, Generic-Edge_Cuts.gbr, Generic-F_Cu.gbr, Generic-F_Mask.gbr, Generic-F_Paste.gbr]
2021-10-07 make pull
    [Generic.kicad_pcb]
2021-11-06 USB-A simple device
    [USBA-B_Cu.gbr, USBA-B_Mask.gbr, USBA-B_Paste.gbr, USBA-B_SilkS.gbr, USBA-Edge_Cuts.gbr, USBA-F_Cu.gbr, USBA-F_Mask.gbr, USBA-F_Paste.gbr]
2021-11-06 New QR
    [USBA-B_Cu.gbr, USBA-B_Mask.gbr, USBA-B_Paste.gbr, USBA-B_SilkS.gbr, USBA-Edge_Cuts.gbr, USBA-F_Cu.gbr, USBA-F_Mask.gbr, USBA-F_Paste.gbr]
2021-11-07 Moved button
    [USBA-B_Cu.gbr, USBA-B_Mask.gbr, USBA-B_Paste.gbr, USBA-B_SilkS.gbr, USBA-Edge_Cuts.gbr, USBA-F_Cu.gbr, USBA-F_Mask.gbr, USBA-F_Paste.gbr]
2021-11-07 As ordered
    [USBA-B_Cu.gbr, USBA-B_Mask.gbr, USBA-B_Paste.gbr, USBA-B_SilkS.gbr, USBA-Edge_Cuts.gbr, USBA-F_Cu.gbr, USBA-F_Mask.gbr, USBA-F_Paste.gbr]
2021-11-10 Revised USB plug
    [USBA-B_Cu.gbr, USBA-B_Mask.gbr, USBA-B_Paste.gbr, USBA-B_SilkS.gbr, USBA-Edge_Cuts.gbr, USBA-F_Cu.gbr, USBA-F_Mask.gbr, USBA-F_Paste.gbr]
2021-11-10 Revised version
    [USBA-B_Cu.gbr, USBA-B_Mask.gbr, USBA-B_Paste.gbr, USBA-B_SilkS.gbr, USBA-Edge_Cuts.gbr, USBA-F_Cu.gbr, USBA-F_Mask.gbr, USBA-F_Paste.gbr]
2021-11-13 Revised plug outline
    [USBA-B_Cu.gbr, USBA-B_Mask.gbr, USBA-B_Paste.gbr, USBA-B_SilkS.gbr, USBA-Edge_Cuts.gbr, USBA-F_Cu.gbr, USBA-F_Mask.gbr, USBA-F_Paste.gbr]
2021-12-30 Kicad 6
    [Generic-B_Cu.gbr, Generic-B_Mask.gbr, Generic-B_Paste.gbr, Generic-B_Silkscreen.gbr, Generic-Edge_Cuts.gbr, Generic-F_Cu.gbr, Generic-F_Mask.gbr, Generic-F_Paste.gbr]
2022-01-02 Curvy tracks
    [USBA-B_Cu.gbr, USBA-B_Mask.gbr, USBA-B_Paste.gbr, USBA-B_Silkscreen.gbr, USBA-Edge_Cuts.gbr, USBA-F_Cu.gbr, USBA-F_Mask.gbr, USBA-F_Paste.gbr]
2022-01-18 Revised to allow for non fixed reg LMR16006 as more available
    [Generic-B_Cu.gbr, Generic-B_Mask.gbr, Generic-B_Paste.gbr, Generic-B_Silkscreen.gbr, Generic-Edge_Cuts.gbr, Generic-F_Cu.gbr, Generic-F_Mask.gbr, Generic-F_Paste.gbr]
2022-01-18 Clean up fab
    [Generic-B_Cu.gbr, Generic-B_Mask.gbr, Generic-B_Paste.gbr, Generic-B_Silkscreen.gbr, Generic-Edge_Cuts.gbr, Generic-F_Cu.gbr, Generic-F_Mask.gbr, Generic-F_Paste.gbr]
2022-01-19 Tidy SS
    [Generic-B_Cu.gbr, Generic-B_Mask.gbr, Generic-B_Paste.gbr, Generic-B_Silkscreen.gbr, Generic-Edge_Cuts.gbr, Generic-F_Cu.gbr, Generic-F_Mask.gbr, Generic-F_Paste.gbr]
2022-01-25 Separate Generic and LowPower boards
    [Generic.csv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]
2022-01-29 More case, but note cases current broken and need updating for new KiCad
    [Generic-nohole.stl, Generic.kicad_pcb, LowPower-nohole.stl, LowPower.stl]
2022-01-29 Change res values for LED
    [Generic-B_Cu.gbr, Generic-B_Mask.gbr, Generic-B_Paste.gbr, Generic-B_Silkscreen.gbr, Generic-Edge_Cuts.gbr, Generic-F_Cu.gbr, Generic-F_Mask.gbr, Generic-F_Paste.gbr]
2022-01-30 New bigger generic and tidy library
    [Generic-B_Cu.gbr, Generic-B_Mask.gbr, Generic-B_Paste.gbr, Generic-B_Silkscreen.gbr, Generic-Edge_Cuts.gbr, Generic-F_Cu.gbr, Generic-F_Mask.gbr, Generic-F_Paste.gbr]
2022-01-30 RGB GPIO on Silkscreen
    [Generic-B_Cu.gbr, Generic-B_Mask.gbr, Generic-B_Paste.gbr, Generic-B_Silkscreen.gbr, Generic-Edge_Cuts.gbr, Generic-F_Cu.gbr, Generic-F_Mask.gbr, Generic-F_Paste.gbr]
2022-01-30 Lots of tidy - mainly silkscreen stuff
    [Generic-B_Cu.gbr, Generic-B_Mask.gbr, Generic-B_Paste.gbr, Generic-B_Silkscreen.gbr, Generic-Edge_Cuts.gbr, Generic-F_Cu.gbr, Generic-F_Mask.gbr, Generic-F_Paste.gbr]
2022-01-31 Moved cap
    [USBA.kicad_pcb]
2022-01-31 New cases
    [Generic-nohole.stl, Generic.stl, LowPower-nohole.stl, LowPower.stl]
2022-02-10 Correct placement and update footprints
    [Generic2-B_Cu.gbr, Generic2-B_Mask.gbr, Generic2-B_Paste.gbr, Generic2-B_Silkscreen.gbr, Generic2-Edge_Cuts.gbr, Generic2-F_Cu.gbr, Generic2-F_Mask.gbr, Generic2-F_Paste.gbr]
2022-02-18 New Generic3 module.
    [Generic3-B_Cu.gbr, Generic3-B_Mask.gbr, Generic3-B_Paste.gbr, Generic3-B_Silkscreen.gbr, Generic3-Edge_Cuts.gbr, Generic3-F_Cu.gbr, Generic3-F_Mask.gbr, Generic3-F_Paste.gbr]
2022-02-18 Tidy USB interface and more silkscreen
    [Generic3-B_Cu.gbr, Generic3-B_Mask.gbr, Generic3-B_Paste.gbr, Generic3-B_Silkscreen.gbr, Generic3-Edge_Cuts.gbr, Generic3-F_Cu.gbr, Generic3-F_Mask.gbr, Generic3-F_Paste.gbr]
2022-02-18 Logo and QR
    [Generic3-B_Cu.gbr, Generic3-B_Mask.gbr, Generic3-B_Paste.gbr, Generic3-B_Silkscreen.gbr, Generic3-Edge_Cuts.gbr, Generic3-F_Cu.gbr, Generic3-F_Mask.gbr, Generic3-F_Paste.gbr]
2022-02-18 Update artwork
    [Generic-B_Cu.gbr, Generic-B_Mask.gbr, Generic-B_Paste.gbr, Generic-B_Silkscreen.gbr, Generic-Edge_Cuts.gbr, Generic-F_Cu.gbr, Generic-F_Mask.gbr, Generic-F_Paste.gbr]
2022-02-18 Tidy artwork
    [Generic2-B_Cu.gbr, Generic2-B_Mask.gbr, Generic2-B_Paste.gbr, Generic2-B_Silkscreen.gbr, Generic2-Edge_Cuts.gbr, Generic2-F_Cu.gbr, Generic2-F_Mask.gbr, Generic2-F_Paste.gbr]
2022-02-18 New artwork
    [Generic3-B_Cu.gbr, Generic3-B_Mask.gbr, Generic3-B_Paste.gbr, Generic3-B_Silkscreen.gbr, Generic3-Edge_Cuts.gbr, Generic3-F_Cu.gbr, Generic3-F_Mask.gbr, Generic3-F_Paste.gbr]
2022-02-18 Artowrk tidy
    [LowPower.kicad_pcb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]
2022-02-19 Tidy GPIO usage
    [Generic3-B_Cu.gbr, Generic3-B_Mask.gbr, Generic3-B_Paste.gbr, Generic3-B_Silkscreen.gbr, Generic3-Edge_Cuts.gbr, Generic3-F_Cu.gbr, Generic3-F_Mask.gbr, Generic3-F_Paste.gbr]
2022-02-20 Fixed USB/DC stuff on Generic.
    [Generic-B_Cu.gbr, Generic-B_Mask.gbr, Generic-B_Paste.gbr, Generic-B_Silkscreen.gbr, Generic-Edge_Cuts.gbr, Generic-F_Cu.gbr, Generic-F_Mask.gbr, Generic-F_Paste.gbr]
2022-02-20 VBUS fixes for Generic2
    [Generic2-B_Cu.gbr, Generic2-B_Mask.gbr, Generic2-B_Paste.gbr, Generic2-B_Silkscreen.gbr, Generic2-Edge_Cuts.gbr, Generic2-F_Cu.gbr, Generic2-F_Mask.gbr, Generic2-F_Paste.gbr]
2022-02-20 Generic3 VBUS tidy
    [Generic3-B_Cu.gbr, Generic3-B_Mask.gbr, Generic3-B_Paste.gbr, Generic3-B_Silkscreen.gbr, Generic3-Edge_Cuts.gbr, Generic3-F_Cu.gbr, Generic3-F_Mask.gbr, Generic3-F_Paste.gbr]
2022-02-20 Clean up GPIOs used to avoid clash with strapping at startup
    [Generic-B_Cu.gbr, Generic-B_Mask.gbr, Generic-B_Paste.gbr, Generic-B_Silkscreen.gbr, Generic-Edge_Cuts.gbr, Generic-F_Cu.gbr, Generic-F_Mask.gbr, Generic-F_Paste.gbr]
2022-02-20 Library tidy
    [Generic.kicad_pcb, Generic.kicad_sch, Generic2.kicad_pcb, Generic2.kicad_sch, Generic3.kicad_pcb]
2022-02-21 New ESP01 style board
    [Generic01-B_Cu.gbr, Generic01-B_Mask.gbr, Generic01-B_Paste.gbr, Generic01-B_Silkscreen.gbr, Generic01-Edge_Cuts.gbr, Generic01-F_Cu.gbr, Generic01-F_Mask.gbr, Generic01-F_Paste.gbr]
2022-02-21 New Generic4 tiny board
    [Generic4-B_Cu.gbr, Generic4-B_Mask.gbr, Generic4-B_Paste.gbr, Generic4-B_Silkscreen.gbr, Generic4-Edge_Cuts.gbr, Generic4-F_Cu.gbr, Generic4-F_Mask.gbr, Generic4-F_Paste.gbr]
2022-02-23 Footprint update
    [Generic-B_Cu.gbr, Generic-B_Mask.gbr, Generic-B_Paste.gbr, Generic-B_Silkscreen.gbr, Generic-Edge_Cuts.gbr, Generic-F_Cu.gbr, Generic-F_Mask.gbr, Generic-F_Paste.gbr]
2022-02-23 More GPIO
    [Generic4-B_Cu.gbr, Generic4-B_Mask.gbr, Generic4-B_Paste.gbr, Generic4-B_Silkscreen.gbr, Generic4-Edge_Cuts.gbr, Generic4-F_Cu.gbr, Generic4-F_Mask.gbr, Generic4-F_Paste.gbr]
2022-02-24 Various minor tidy
    [Generic.kicad_pcb, Generic.kicad_sch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]
2022-02-25 General tracking tidy
    [Generic3-B_Cu.gbr, Generic3-B_Mask.gbr, Generic3-B_Paste.gbr, Generic3-B_Silkscreen.gbr, Generic3-Edge_Cuts.gbr, Generic3-F_Cu.gbr, Generic3-F_Mask.gbr, Generic3-F_Paste.gbr]
2022-03-02 PCB thickness corrections
    [Generic3.kicad_pcb, Generic4.kicad_pcb, LowPower-nohole.stl, LowPower.kicad_pcb, LowPower.stl]
2022-03-03 New 3D
    [Generic4.stl]
2022-03-04 Started on Generic5
    [Generic4-B_Cu.gbr, Generic4-B_Mask.gbr, Generic4-B_Paste.gbr, Generic4-B_Silkscreen.gbr, Generic4-Edge_Cuts.gbr, Generic4-F_Cu.gbr, Generic4-F_Mask.gbr, Generic4-F_Paste.gbr]
2022-03-04 New Generic5
    [Generic5-B_Cu.gbr, Generic5-B_Mask.gbr, Generic5-B_Paste.gbr, Generic5-B_Silkscreen.gbr, Generic5-Edge_Cuts.gbr, Generic5-F_Cu.gbr, Generic5-F_Mask.gbr, Generic5-F_Paste.gbr]
2022-03-04 Extra links
    [Generic.stl, Generic2.stl, Generic3.stl, Generic4.stl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]
2022-03-04 Tidy tracks
    [Generic5-B_Cu.gbr, Generic5-B_Mask.gbr, Generic5-B_Paste.gbr, Generic5-B_Silkscreen.gbr, Generic5-Edge_Cuts.gbr, Generic5-F_Cu.gbr, Generic5-F_Mask.gbr, Generic5-F_Paste.gbr]
2022-03-04 Fix 3D
    [Generic5.stl]
2022-03-04 New 5V link
    [Generic.stl, Generic2.kicad_pcb, Generic2.stl, Generic3.kicad_pcb, Generic3.stl, Generic4.stl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]
2022-03-05 Ready for order
    [Generic-B_Cu.gbr, Generic-B_Mask.gbr, Generic-B_Paste.gbr, Generic-B_Silkscreen.gbr, Generic-Edge_Cuts.gbr, Generic-F_Cu.gbr, Generic-F_Mask.gbr, Generic-F_Paste.gbr]
2022-03-05 Added buzzer
    [Generic3-B_Cu.gbr, Generic3-B_Mask.gbr, Generic3-B_Paste.gbr, Generic3-B_Silkscreen.gbr, Generic3-Edge_Cuts.gbr, Generic3-F_Cu.gbr, Generic3-F_Mask.gbr, Generic3-F_Paste.gbr]
2022-03-05 Part no
    [Generic3-B_Cu.gbr, Generic3-B_Mask.gbr, Generic3-B_Paste.gbr, Generic3-B_Silkscreen.gbr, Generic3-Edge_Cuts.gbr, Generic3-F_Cu.gbr, Generic3-F_Mask.gbr, Generic3-F_Paste.gbr]
2022-03-05 FET and diode logic
    [Generic3-B_Cu.gbr, Generic3-B_Mask.gbr, Generic3-B_Paste.gbr, Generic3-B_Silkscreen.gbr, Generic3-Edge_Cuts.gbr, Generic3-F_Cu.gbr, Generic3-F_Mask.gbr, Generic3-F_Paste.gbr]
2022-03-05 Changed FET drive to pin 3 on Generic5, and reverted Generic3
    [Generic.stl, Generic2.stl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]
2022-03-08 Started pwm
2022-03-10 Tidy 3D
    [Generic.stl, Generic2.stl, Generic3.stl, Generic4.stl, Generic5.stl, LowPower.stl]
2022-03-10 DRC tidy
    [Generic3-B_Cu.gbr, Generic3-B_Mask.gbr, Generic3-B_Paste.gbr, Generic3-B_Silkscreen.gbr, Generic3-Edge_Cuts.gbr, Generic3-F_Cu.gbr, Generic3-F_Mask.gbr, Generic3-F_Paste.gbr]
2022-03-11 DRC tweak
    [Generic.stl, Generic2.stl, Generic3.kicad_pcb, Generic3.stl, Generic4.kicad_pcb, Generic4.stl, Generic5.kicad_pcb, Generic5.stl]
2022-03-11 Tidy up 3D
    [Generic.stl, Generic2.stl, Generic4.stl, LowPower.stl]
2022-03-16 Tweak for smoother power, and change of regulator FB pot divide
    [Generic4-B_Cu.gbr, Generic4-B_Mask.gbr, Generic4-B_Paste.gbr, Generic4-B_Silkscreen.gbr, Generic4-Edge_Cuts.gbr, Generic4-F_Cu.gbr, Generic4-F_Mask.gbr, Generic4-F_Paste.gbr]
2022-03-17 Change resistor values
    [Generic.csv, Generic.kicad_pcb, Generic.kicad_sch, Generic2.csv, Generic2.kicad_pcb, Generic2.kicad_sch, Generic3.csv, Generic3.kicad_pcb]
2022-03-17 Broken - moving to GFX library
    [Generic.c]
2022-03-29 Changed to have C/R for EN
    [Generic4-B_Cu.gbr, Generic4-B_Mask.gbr, Generic4-B_Paste.gbr, Generic4-B_Silkscreen.gbr, Generic4-Edge_Cuts.gbr, Generic4-F_Cu.gbr, Generic4-F_Mask.gbr, Generic4-F_Paste.gbr]
2022-04-04 Extra tiny board with optional components. Smallest yet
    [Generic0-B_Cu.gbr, Generic0-B_Mask.gbr, Generic0-B_Paste.gbr, Generic0-B_Silkscreen.gbr, Generic0-Edge_Cuts.gbr, Generic0-F_Cu.gbr, Generic0-F_Mask.gbr, Generic0-F_Paste.gbr]
2022-04-04 Tidy Generic 4 Started on Generic 6
    [Generic4-B_Cu.gbr, Generic4-B_Mask.gbr, Generic4-B_Paste.gbr, Generic4-B_Silkscreen.gbr, Generic4-Edge_Cuts.gbr, Generic4-F_Cu.gbr, Generic4-F_Mask.gbr, Generic4-F_Paste.gbr]
2022-05-01 New Generic board 6
    [Generic6-B_Cu.gbr, Generic6-B_Mask.gbr, Generic6-B_Paste.gbr, Generic6-B_Silkscreen.gbr, Generic6-Edge_Cuts.gbr, Generic6-F_Cu.gbr, Generic6-F_Mask.gbr, Generic6-F_Paste.gbr]
2022-05-01 Generic 6 not finished
    [Generic6.kicad_pcb, Generic6.kicad_sch]
2022-05-02 Generic 6 tracked
    [Generic6-B_Cu.gbr, Generic6-B_Mask.gbr, Generic6-B_Paste.gbr, Generic6-B_Silkscreen.gbr, Generic6-Edge_Cuts.gbr, Generic6-F_Cu.gbr, Generic6-F_Mask.gbr, Generic6-F_Paste.gbr]
2022-05-28 Tweak icon
    [Generic0.kicad_pcb]
2023-01-03 USB plug generic
    [USBA-B_Cu.gbr, USBA-B_Mask.gbr, USBA-B_Paste.gbr, USBA-B_Silkscreen.gbr, USBA-Edge_Cuts.gbr, USBA-F_Cu.gbr, USBA-F_Mask.gbr, USBA-F_Paste.gbr]
2023-01-05 PCB make
    [Generic.scad, Generic2.scad, Generic3.scad, Generic4.scad, Generic5.scad, LowPower.scad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]
2023-01-05 PCB zip file in Make
    [USBA-B_Cu.gbr, USBA-B_Mask.gbr, USBA-B_Paste.gbr, USBA-B_Silkscreen.gbr, USBA-Edge_Cuts.gbr, USBA-F_Cu.gbr, USBA-F_Mask.gbr, USBA-F_Paste.gbr]
2023-01-05 Latest and zips
    [Generic-B_Cu.gbr, Generic-B_Mask.gbr, Generic-B_Silkscreen.gbr, Generic-Edge_Cuts.gbr, Generic-F_Cu.gbr, Generic-F_Mask.gbr, Generic-F_Silkscreen.gbr, Generic-NPTH.drl]
2023-01-09 Moved PCB directory
    [Generic-B_Cu.gbr, Generic-B_Mask.gbr, Generic-B_Silkscreen.gbr, Generic-Edge_Cuts.gbr, Generic-F_Cu.gbr, Generic-F_Mask.gbr, Generic-F_Silkscreen.gbr, Generic-NPTH.drl]
2023-02-10 New layout for production
    [USBA.kicad_pcb, USBA.kicad_sch, bom.csv, designators.csv, positions.csv]
2023-02-17 Started a variation
    [USBA2.kicad_pcb, USBA2.kicad_sch]
2023-02-17 Right angle version
    [USBA.kicad_pcb, USBA2.kicad_pcb, bom.csv, designators.csv, positions.csv]
2023-03-18 New layoput
    [USBA.kicad_pcb, USBA2.kicad_pcb, USBA2.kicad_sch, positions.csv]
2023-04-06 More tidy
    [Generic.kicad_pcb, Generic.kicad_sch, Generic0.kicad_pcb, Generic0.kicad_sch, Generic2.kicad_pcb, Generic2.kicad_sch, bom.csv, positions.csv]
2023-04-07 New LED Generic 5
    [Generic5.kicad_pcb, Generic5.kicad_sch, bom.csv, designators.csv, positions.csv]
2023-04-07 New PCB
    [Generic.scad, Generic.stl, Generic2.scad, Generic2.stl, Generic3.scad, Generic3.stl, Generic4.scad, Generic4.stl]
2023-04-08 Moved PCB
    [LED.kicad_pcb, LED.kicad_sch, LED.scad, LED.stl, bom.csv, designators.csv, positions.csv]
2023-06-14 Production files
    [Generic01.kicad_pcb, Generic01.kicad_sch, bom.csv, designators.csv, positions.csv]
2023-06-14 Move RST
    [Generic01.kicad_pcb, Generic01.kicad_sch]
2023-06-14 Tidy RST as EN
    [Generic01.kicad_pcb, Generic01.kicad_sch, bom.csv, designators.csv, positions.csv]
2023-06-17 Started some updates, not all complete
    [Generic2.kicad_pcb, Generic3.kicad_pcb, Generic4.kicad_pcb, Generic4.kicad_sch, Generic6.kicad_pcb, Generic6.kicad_sch, bom.csv, designators.csv]
2023-06-17 Messing around, not good
    [Generic2.kicad_pcb, Generic2.kicad_sch]
2023-06-20 Simple USBA with CH340X
    [USBA2.kicad_pcb, USBA2.kicad_sch, USBA2.scad, USBA2.stl, bom.csv, designators.csv, positions.csv]
2023-06-20 Smaller footprint on CH340X
    [USBA.kicad_pcb, USBA2.kicad_pcb, positions.csv]
2023-06-21 Rotation fixes
    [USBA2.kicad_pcb, USBA2.kicad_sch, positions.csv]
2023-06-25 Extra silk screen
    [USBA.kicad_pcb]
2023-06-26 Re panel
    [USBA.kicad_pcb, USBA.kicad_sch, bom.csv, designators.csv, positions.csv]
2023-06-26 Tear drops
    [USBA.kicad_pcb]
2023-06-26 FFS missing 4k7
    [USBA.kicad_pcb, USBA.kicad_sch, bom.csv, designators.csv, positions.csv]
2023-06-26 V Cuts
    [USBA.kicad_pcb]
2023-06-27 Better rails
    [USBA.kicad_pcb, USBA.kicad_sch, bom.csv, designators.csv, positions.csv]
2023-06-27 Fix CH340X
    [USBA.kicad_pcb, USBA.kicad_sch, positions.csv]
2023-06-29 Move UART, and tidy
    [USBA.kicad_pcb, positions.csv]
2023-06-30 Added H.T
    [USBA.kicad_pcb, USBA.kicad_sch, bom.csv, designators.csv, positions.csv]
2023-07-07 Wow, stack does not work!
    [Generic.c]
2023-07-13 Swapped around a bit
    [USBA.kicad_pcb, positions.csv]
2023-07-20 Started rework for single sided
    [USBA.kicad_pcb, USBA.kicad_sch]
2023-07-20 New layout
    [USBA.kicad_pcb, USBA.kicad_sch, bom.csv, designators.csv, positions.csv]
2023-07-20 Needs tracks tidying
    [USBA.kicad_pcb]
2023-07-20 Cleaner tracks
    [USBA.kicad_pcb]
2023-07-27 1mm with glued bits
    [USBA.kicad_pcb, USBA.kicad_sch, designators.csv, positions.csv]
2023-08-01 New ESP32-S3 based module
    [USBA.kicad_pcb, USBA.kicad_sch, USBA.scad, USBA.stl, bom.csv, designators.csv, positions.csv]
2023-08-01 Fix cuts
    [USBA.kicad_pcb, positions.csv]
2023-08-01 Tidy, fix GND, and add tear drops
    [USBA.kicad_pcb, USBA.kicad_sch]
2023-08-01 Test board
    [GenericS3.kicad_pcb, GenericS3.kicad_sch, bom.csv, designators.csv, positions.csv]
2023-08-02 Added GND pads
    [GenericS3.kicad_pcb, GenericS3.kicad_sch, designators.csv, positions.csv]
2023-08-04 Added connector
    [GenericS3.kicad_pcb, GenericS3.kicad_sch, bom.csv, designators.csv, positions.csv]
2023-08-04 Cut out
    [GenericS3.kicad_pcb, positions.csv]
2023-08-04 Remove socket from BOM
    [GenericS3.kicad_pcb, GenericS3.kicad_sch, bom.csv]
2023-08-04 ESD symbol on silk
    [GenericS3.kicad_pcb]
2023-08-04 Added 3V3 pads as well
    [GenericS3.kicad_pcb, GenericS3.kicad_sch, designators.csv, positions.csv]
2023-08-05 Changed diode
    [GenericS3.kicad_pcb, GenericS3.kicad_sch, bom.csv, positions.csv]
2023-08-05 Fix diode and barcode
    [GenericS3.kicad_pcb, GenericS3.kicad_sch, designators.csv, positions.csv]
2023-08-06 PROG under ESP
    [GenericS3.kicad_pcb, GenericS3.kicad_sch, USBA.kicad_pcb, bom.csv, designators.csv, positions.csv]
2023-08-07 Not quite ready for ESP32S3 yet
2023-08-08 Added buttons
    [GenericS3.kicad_pcb, GenericS3.kicad_sch, USBA.kicad_pcb, bom.csv, designators.csv, positions.csv]
2023-08-09 USBA as latest, and improve silk screen
    [USBA.kicad_pcb, USBA.kicad_sch, USBA.scad, USBA.stl, USBA2.kicad_pcb, USBA2.kicad_sch, USBA2.scad, USBA2.stl]
2023-08-09 Smaller footprint
    [USBA.kicad_pcb, USBA.kicad_sch, positions.csv]
2023-08-09 Ordered smaller
    [USBA.kicad_pcb, positions.csv]
2023-08-10 No buttons
    [GenericS3.kicad_pcb, GenericS3.kicad_sch, bom.csv, designators.csv, positions.csv]
2023-08-10 Packed in to 30x30mm
    [GenericS3.kicad_pcb, GenericS3.kicad_sch, designators.csv, positions.csv]
2023-08-10 Smaller diode
    [GenericS3.kicad_pcb, GenericS3.kicad_sch, bom.csv, positions.csv]
2023-08-11 No barcode
    [GenericS3.kicad_pcb, GenericS3.kicad_sch, designators.csv, positions.csv]
2023-08-18 Tidy up silk screen for glue on tab
    [USBA.kicad_pcb]
2023-08-19 New reg
    [GenericS3.kicad_pcb, USBA.kicad_pcb, USBA.kicad_sch, positions.csv]
2023-08-29 Added USB pads to allow programming in panel
    [USBA.kicad_pcb, USBA.kicad_sch, bom.csv, designators.csv, positions.csv]
2023-09-05 Changed to WS2812
    [GenericS3.kicad_pcb, USBA.kicad_pcb, USBA.kicad_sch, bom.csv, designators.csv, positions.csv]
2023-09-28 Slight angle fixed
    [USBA.kicad_pcb, USBA.kicad_sch]
2023-10-10 Changed to light sensor
    [USBA.kicad_pcb, USBA.kicad_sch, bom.csv, designators.csv, positions.csv]
2023-10-19 Added 3 pads for LED
    [USBA.kicad_pcb, USBA.kicad_sch, designators.csv, positions.csv]
2023-10-28 USB-C version
    [USBC.kicad_pcb, USBC.kicad_sch, bom.csv, designators.csv, positions.csv]
2023-10-28 Better layout
    [USBC.kicad_pcb, USBC.kicad_sch, positions.csv]
2023-10-28 Remove EAN for now
    [USBC.kicad_pcb]
2023-10-28 Reworked, double sided (meh), and more LEDs
    [USBC.kicad_pcb, USBC.kicad_sch, bom.csv, designators.csv, positions.csv]
2023-10-28 More caps
    [USBC.kicad_pcb, USBC.kicad_sch, bom.csv, designators.csv, positions.csv]
2023-10-28 Tidy for production
    [USBC.kicad_pcb, USBC.kicad_sch, positions.csv]
2023-10-28 Tidy for prod
    [USBC.kicad_pcb, USBC.kicad_sch, bom.csv, positions.csv]
2023-10-28 Update README.md
    Button
2023-10-28 Added simple GPIO0 LED
    [USBC.kicad_pcb, USBC.kicad_sch, bom.csv, designators.csv, positions.csv]
2023-10-28 Labeled 0
    [USBC.kicad_pcb]
2023-11-04 FFS - different CC logic for a plug
    [USBC.kicad_pcb, USBC.kicad_sch, bom.csv, designators.csv, positions.csv]
2023-11-05 More solid plug
    [USBC.kicad_pcb, USBC.kicad_sch, bom.csv, positions.csv]
2023-11-05 Fix CC
    [USBC.kicad_pcb, USBC.kicad_sch, bom.csv, positions.csv]
2024-08-11 Tweak layout
    [GenericS3.kicad_pcb, GenericS3.kicad_sch, USBA.kicad_pcb, USBA.kicad_sch, USBC.kicad_pcb, USBC.kicad_sch, bom.csv, designators.csv]
2024-08-20 Tweak layout for WAGO on back
    [USBA.kicad_pcb, USBA.kicad_sch, bom.csv, designators.csv, positions.csv]
2024-08-20 Re do GPIO
    [USBA.kicad_pcb, USBA.kicad_sch]
2024-08-20 Put back I2C device
    [USBA.kicad_pcb, USBA.kicad_sch, bom.csv, designators.csv, positions.csv]
2024-08-21 New design, 3 pin WAGO for LED, I2S microphone, and colour sensor.
    [USBA.kicad_pcb, USBA.kicad_sch, bom.csv, designators.csv, positions.csv]
2024-08-25 Tidy mic
    [USBA.kicad_pcb, positions.csv]
2024-08-26 New EAN
    [USBA.kicad_pcb]
2024-08-27 Tidy tab and add extra cap and ESD
    [USBA.kicad_pcb, USBA.kicad_sch, bom.csv, designators.csv, positions.csv]
2024-09-02 Tweak wago placement
    [USBA.kicad_pcb, USBA.kicad_sch, positions.csv]
2024-09-03 Moved to LED
    [USBA.kicad_pcb, USBA.kicad_sch, USBA.scad, USBA.stl, bom.csv, designators.csv, positions.csv]
2025-01-23 PCB Update
    [Generic.kicad_pcb, Generic.kicad_sch, Generic0.kicad_pcb, Generic0.kicad_sch, Generic01.kicad_pcb, Generic01.kicad_sch, Generic2.kicad_pcb, Generic2.kicad_sch]
2025-07-02 New renders and new S3
    [GenericS3.kicad_pcb, GenericS3.kicad_sch]
2025-07-03 ready to order
    [GenericS3.kicad_pcb, GenericS3.kicad_sch, bom.csv, designators.csv, positions.csv]
2025-07-05 Tidy up a bit
    [GenericS3.kicad_pcb, GenericS3.kicad_sch, bom.csv, designators.csv, positions.csv]
2025-07-09 New render
    [GenericS3.kicad_pcb, positions.csv]
2025-07-10 Reference battery started
    [GenericS3.kicad_pcb, GenericS3.kicad_sch]
2025-07-11 Added diode
    [GenericS3.kicad_pcb, GenericS3.kicad_sch, bom.csv, designators.csv, positions.csv]
2025-07-17 Change reg
    [GenericS3.kicad_pcb, GenericS3.kicad_sch, bom.csv]
2025-07-19 led strip
2025-07-20 Started logic - need to rework LoRa code
    [Generic.c, lora.c]
2025-07-24 Latest tweaks
    [GenericS3.kicad_pcb, GenericS3.kicad_sch, bom.csv, designators.csv, positions.csv]
2025-07-24 More caps, and change to ceramic
    [GenericS3.kicad_pcb, GenericS3.kicad_sch, bom.csv, designators.csv, positions.csv]
2025-07-24 3A diodes
    [GenericS3.kicad_pcb, GenericS3.kicad_sch, bom.csv]
2025-07-26 Tweak layout a bit
    [GenericS3.kicad_pcb, GenericS3.kicad_sch]
2025-08-25 New case
    [GenericS3B.scad, GenericS3B.stl, GenericS3T.scad, GenericS3T.stl]
2025-08-25 Improved README
    [GenericS3B.scad, GenericS3B.stl, GenericS3T.scad, GenericS3T.stl]
2025-10-10 new LEDs
    [GenericS3.kicad_pcb, GenericS3.kicad_sch, bom.csv]
2025-11-13 Actuator logic and new LEDs
